Fotomaterjal/dolly/Asjad/20141008_165119.jpg

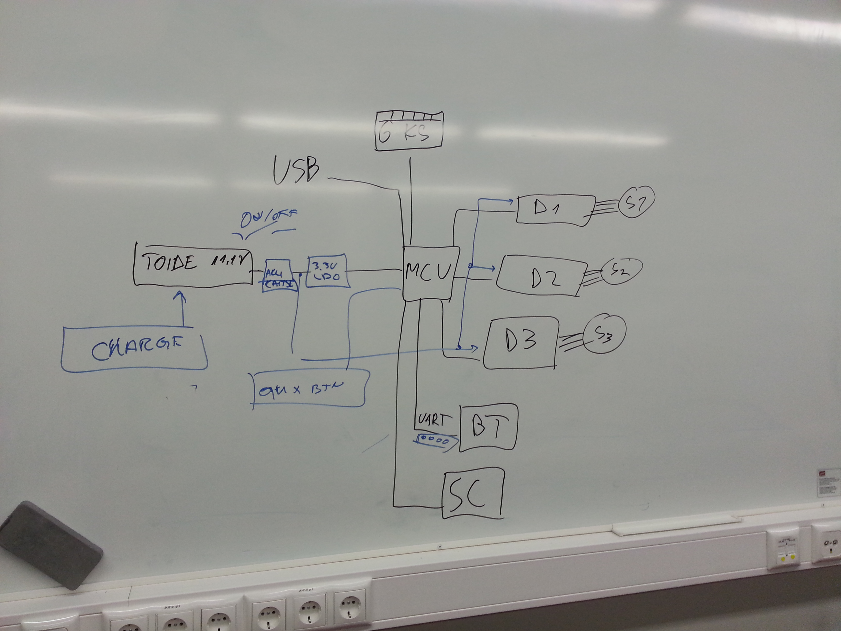
Asjad/20141008_165119.jpg
