Fotomaterjal/dolly/Asjad/work in progress_solid.PNG

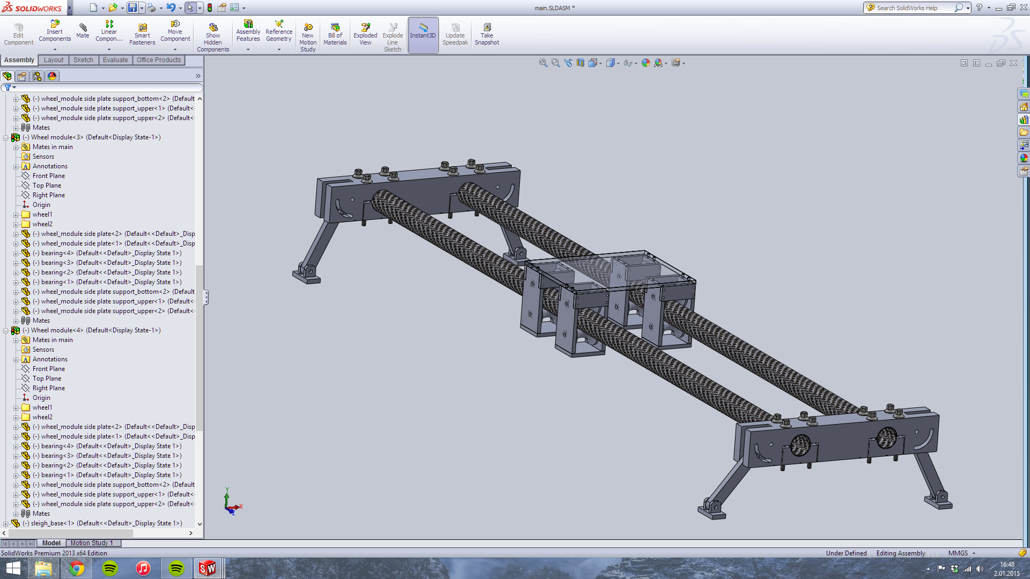
Asjad/work in progress_solid.PNG
