Fotomaterjal/dolly/Asjad/Plokkskeem.docx

UART

Start/stop

ON/OFF switch

3.3V

Battery protect

Charge

Power
11.1 V

BLUETOOTH

USB

Shutter control

6 killswitches

S1

S3

Driver 3

Driver 1

MCU

S2

Driver 2
