Fotomaterjal/dolly/Solidworks/Eelarve_B26135_lõputöö.pdf

Komponent | Kogus | Hind kokku € (koos tellimisega)

# Link

Süsinikkiust relss 1200 mm | 2 | 75 http://www.ebay.com/itm/1pcs-30X28X1200MM-Carbon-fiber-tube-for-Quadcopter-Hexrcopter-arm-3K-Twill-matt-/221540058010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
Steppermootor | 3 | 144 http://www.ebay.com/itm/17Kg-cm-42-Stepper-Motor-with-5mm-Shaft-5-18-1-Planetary-Gearbox-for-3D-Printer-/141391145774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
Laagrid ülekannete jaoks | 3 | 12
Laagrid kaamera aluse tarvis | 2 | 15
Laagrid rataste jaoks | 8 | 18
Liblikmutrid | 8 | 8
Vintraud | 1 | 8
Poldid | 48 | 14
Mutrid | 40 | 10
Ülekanderihm | 1 | 10 http://www.ebay.com/itm/RepRap-2x-GT2-20T-5mm-Bore-Pulleys-2M-Timing-Belt-Set-for-3D-printer-Prusa-FE-/121428898130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
3D-printeri plastik | 1 | 20
Peegelkaamera statiivpea | 1 | 39 http://www.ebay.com/itm/15KG-Aluminum-Ball-Head-Ballhead-Quick-Release-Plate-for-Tripod-DSLR-Camera-/181397654016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
Raud/alumiinium | 1 | 45
Separaatorid | 18 | 15
Aku | 1 | 32 http://www.ebay.com/itm/YKS-11-1V-5000mah-25C-MAX-40C-3S-Lipo-Battery-For-RC-Helicopter-Plane-/171404551408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
Lipoplaat | 1 | 6 http://www.ebay.com/itm/A-PCM-Protection-Circuit-Module-For-11-1V-3S-Li-ion-Li-Po-Battery-pack-6A-SM936-/220967028845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
Lipo kott | 1 | 3,7 http://www.ebay.com/itm/NEW-LiPo-RC-Battery-Safe-Guard-bag-Charging-Sack-save-pack-E-/261480890022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
Kaablid mootorite/päästiku jaoks | 3 | 9
Lipo laadija | 1 | 52 http://www.ebay.com/itm/iMAX-B6AC-RC-R-C-Plane-Car-LiPo-LiIon-LiFe-NiCd-NiMh-Battery-Balance-Charger-/171327219127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
Kokku: | 535,7
