Fotomaterjal/dolly/Eagle/Electronics links.xlsx

Jupp | Kogus | Hind kokku | Saadavus | Link | äkki on see parem
Allegromicro A4984 stepperi draiver | 3 |  |  | http://ee.farnell.com/allegro-microsystems/a4982slptr-t/motor-driver-microstepping-24tssop/dp/2057415
Bluetooth HC-06 | 1 | 3.60 |  | http://www.ebay.com/itm/Wireless-Serial-4-Pin-Bluetooth-RF-Transceiver-Module-HC-06-RS232-With-backplane-/200924726178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
ATMEGA32U4 mikrokontroller | 1 | 5.89 |  | http://ee.farnell.com/atmel/atmega32u4-au/mcu-8bit-megaavr-16mhz-tqfp-44/dp/1748525?ref=lookahead
16 MHz kristall | 1 | 0.63 |  | http://ee.farnell.com/txc/9c-16-000meej-t/xtal-16-000mhz-18pf-smd-hc-49s/dp/1842294
Phototransistor | 1 | 0.603 |  | http://ee.farnell.com/fairchild-semiconductor/fod814a3sd/opto-cplr-phototrans-5kv-smd/dp/2322512
Screw terminal for motors | 3 | 3.06 |  | http://ee.farnell.com/multicomp/mc000036/terminal-block-pcb-5-08mm-4way/dp/2008006
100nF kondekad | 10 | 3.6 |  | http://ee.farnell.com/avx/06033c104jat2a/cap-mlcc-x7r-100nf-25v-0603/dp/1740614
1uF kondekad | 10 | 3.6 |  | http://ee.farnell.com/avx/06033d105kat2a/cap-mlcc-x5r-1uf-25v-0603/dp/1658868
10uF kondekad | 10 | 2.34 |  | http://ee.farnell.com/avx/12063c106kat2a/cap-mlcc-x7r-10uf-25v-1206/dp/2094044
100uF tantaal | 3 | 10.1 |  | http://ee.farnell.com/vishay-sprague/595d107x0025r2t/cap-tant-100uf-25v-case-r/dp/1469337
voltage regulator | 1 | 2.42 |  | http://ee.farnell.com/analog-devices/adp2302ardz-3-3/ic-buck-reg-2a-3-3v-8soic/dp/1843644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
shottky diood | 1 | 0.34 |  | http://ee.farnell.com/multicomp/b330b-13-f/diode-schottky-3a-30v-do-214aa/dp/2306114
inductor | 1 | 1.15 |  | http://ee.farnell.com/tdk/vlf10040t-6r8n4r5/inductor-power-line-6-8uh-4-5a/dp/1855390
USB connector | 1 |  |  | http://ee.farnell.com/samtec/musb-05-s-b-sm-a/connector-mini-usb-b-receptacle/dp/1753806
