Fotomaterjal/dolly/Asjad/Capture1.PNG

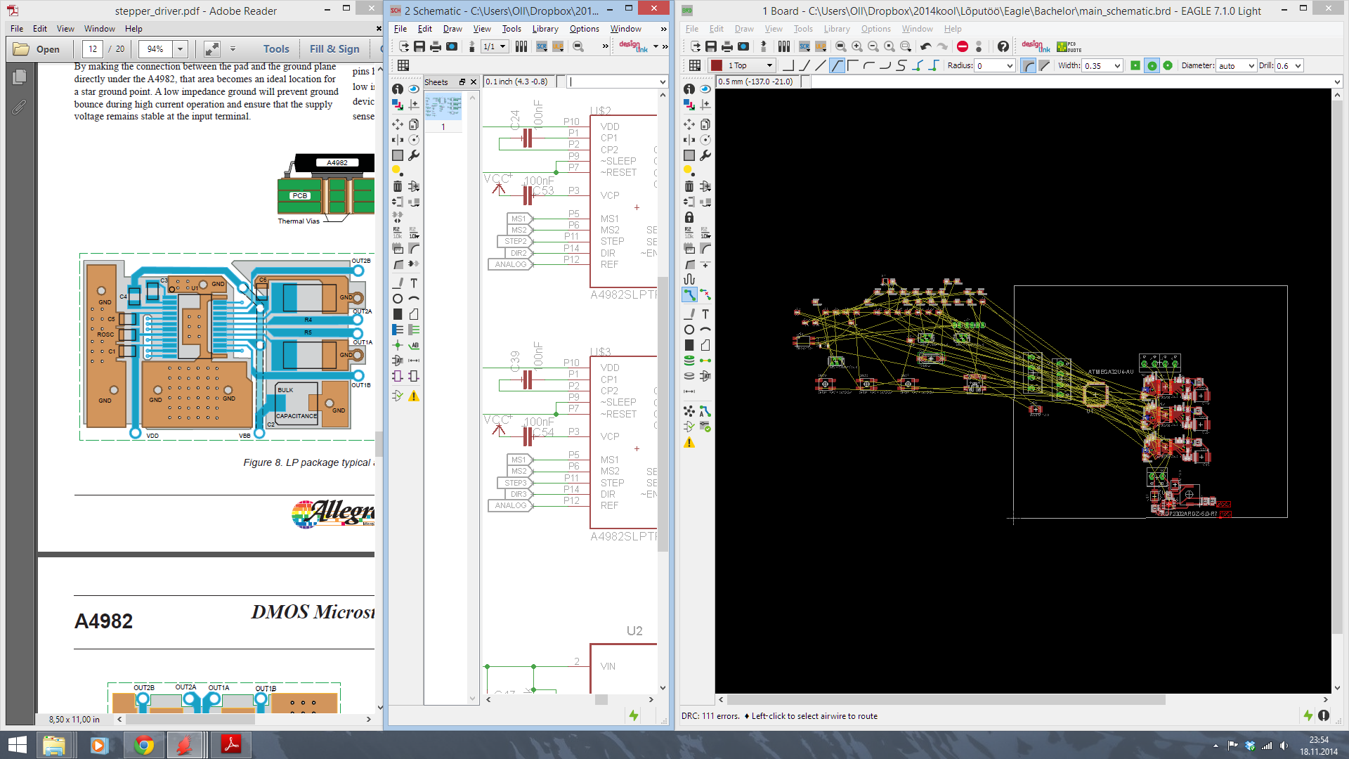
Asjad/Capture1.PNG
