Fotomaterjal/dolly/Asjad/Capture.PNG

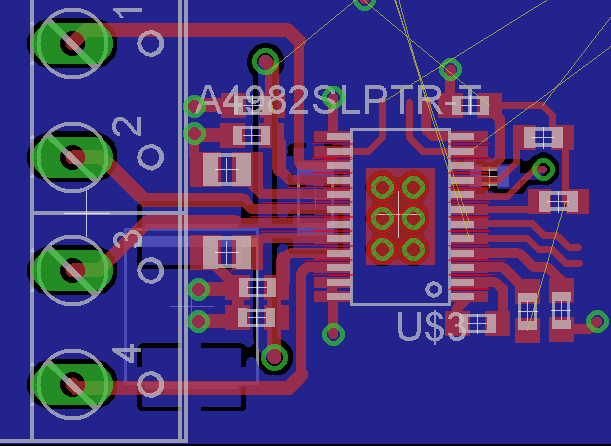
Asjad/Capture.PNG
