Fotomaterjal/dolly/Asjad/kogu plaat.PNG

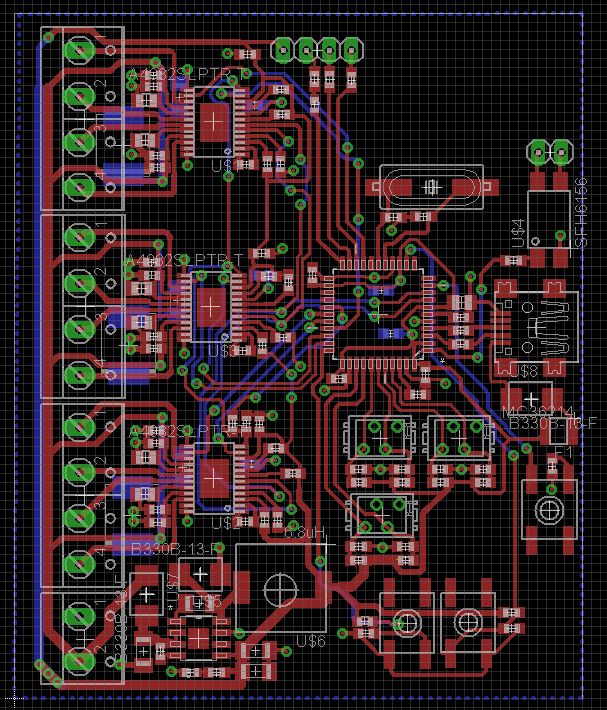
Asjad/kogu plaat.PNG
