Fotomaterjal/dolly/Asjad/plaat valma.PNG

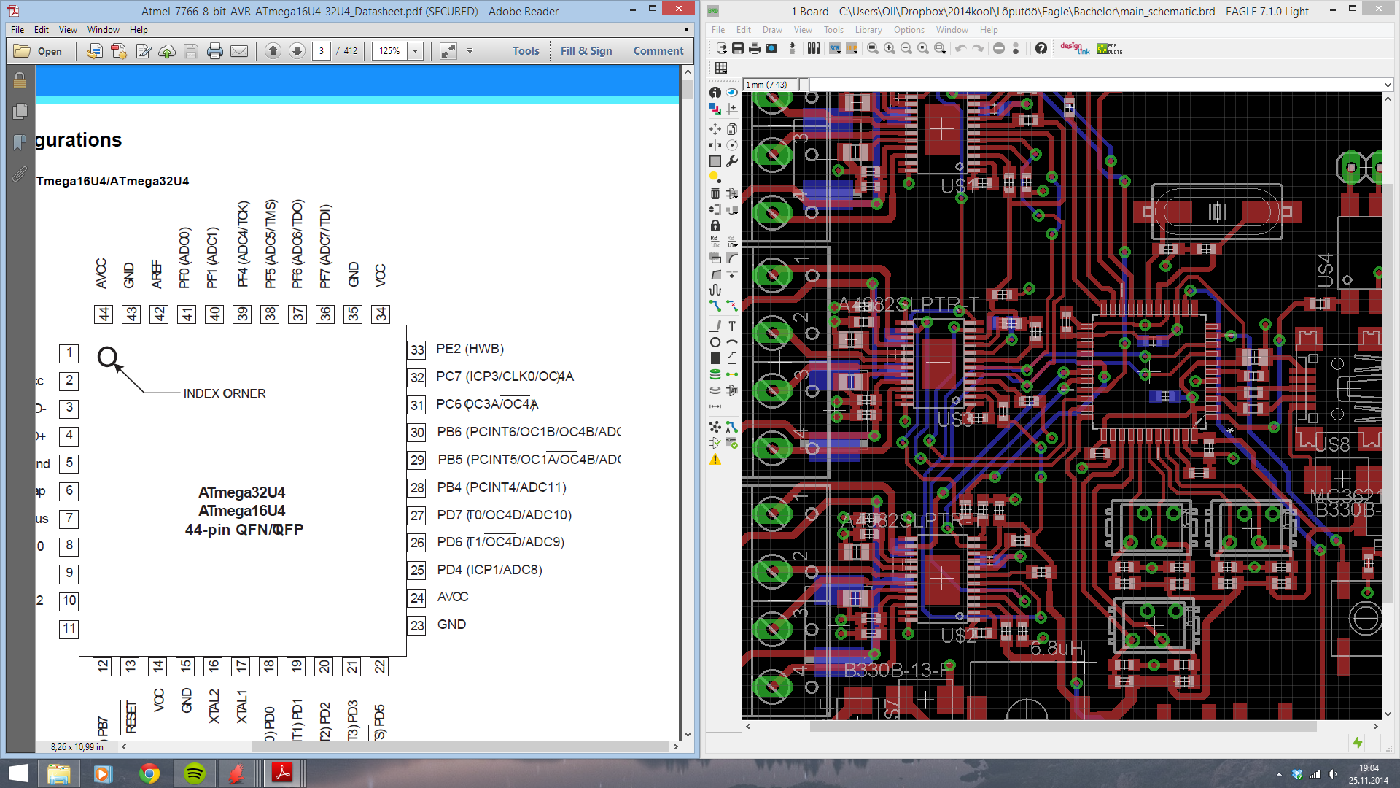
Asjad/plaat valma.PNG
