Fotomaterjal/dolly/Asjad/plokkskeem.PNG

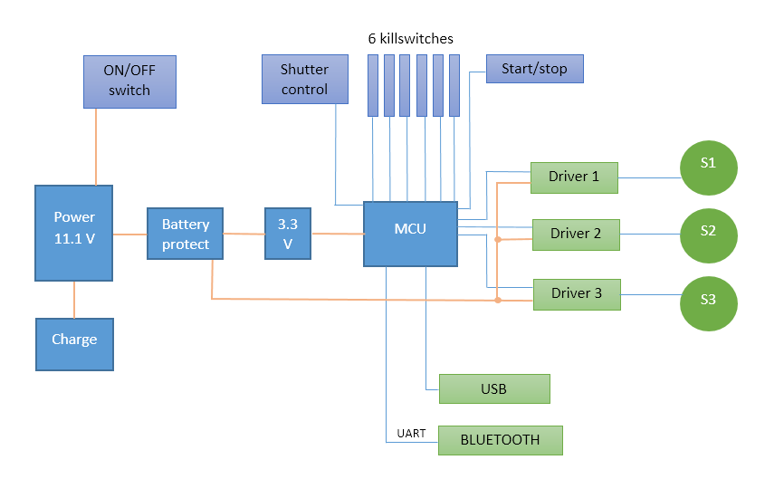
Asjad/plokkskeem.PNG
