Fotomaterjal/dolly/Asjad/work in progress.PNG

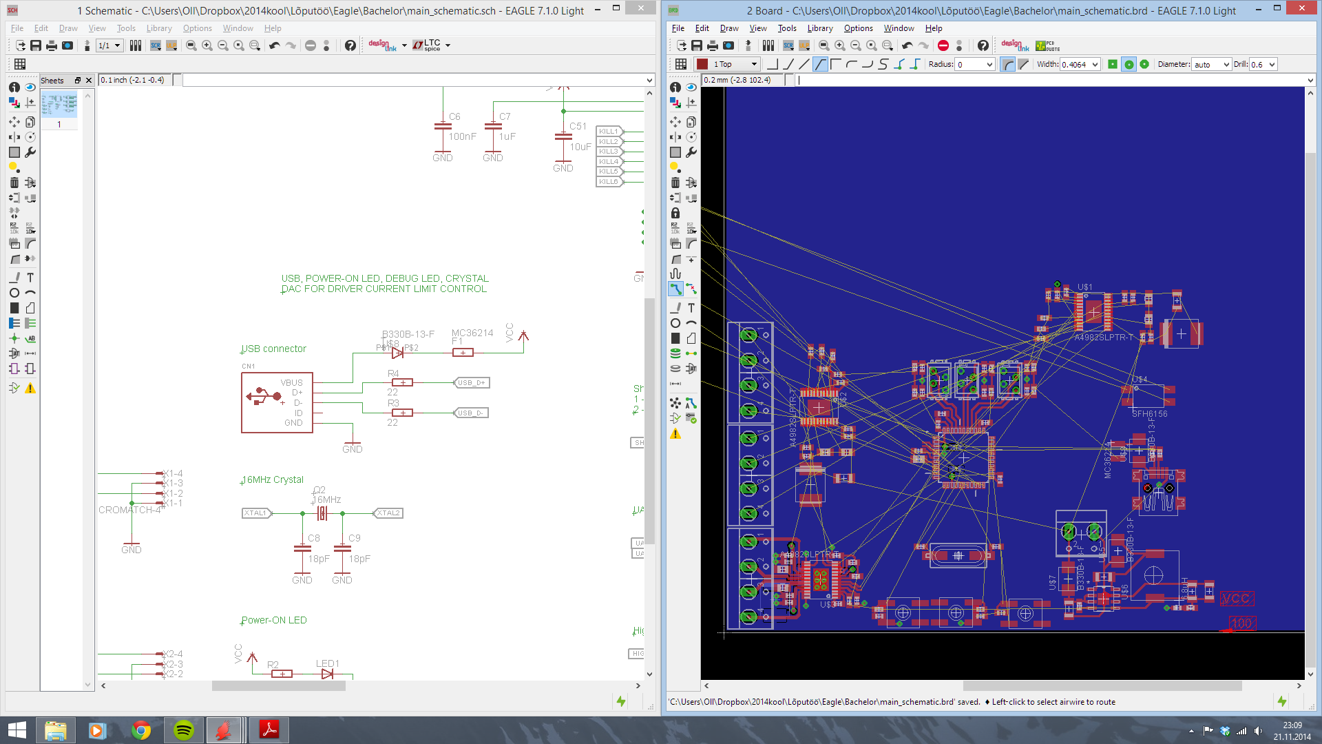
Asjad/work in progress.PNG
