Fotomaterjal/dolly/Asjad/ühenda draiver nii.PNG

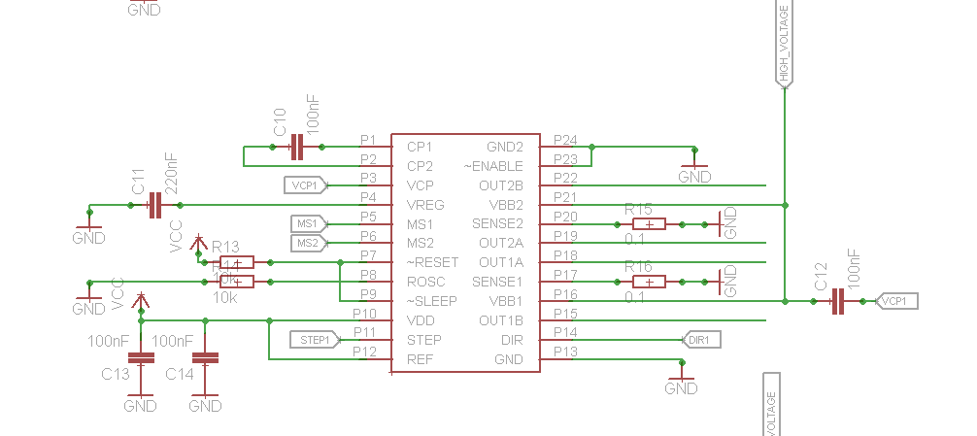
Asjad/ühenda draiver nii.PNG
