Fotomaterjal/dolly/Eagle/mida ühendada.PNG

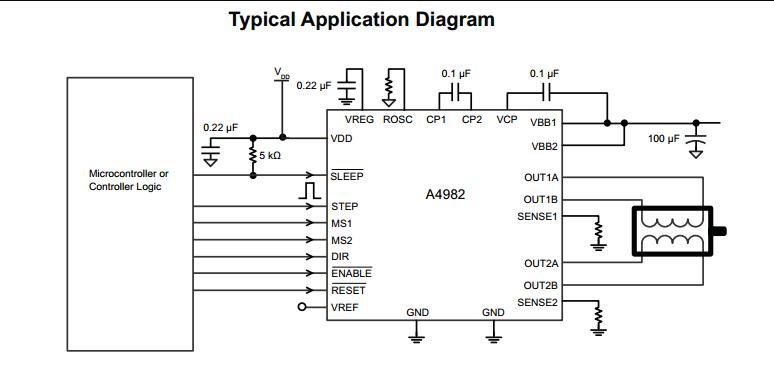
Eagle/mida ühendada.PNG
