Fotomaterjal/dolly/Progemine/cheatsheet.PNG

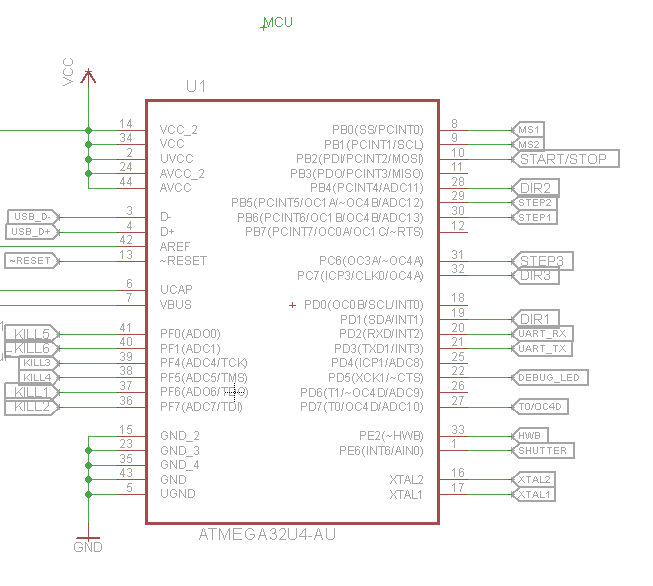
Progemine/cheatsheet.PNG
