Fotomaterjal/dolly/Eagle/BOM revisited2.txt

22uF, 2th, 1206			ok
LED 0603
Dioodid, 5tk			ok
0.1 oomi 0805, 10tk		ok
3,9k 0603			ok
100uF tantaalid 1469337 4tk	ok

1469337, 4, Salumaa CAP TANT 100UF 25V CASE R
1680071, 4, Salumaa RSX501L-20TE25  DIODE, SCHOTTKY
2320923, 10, Salumaa CAP MLCC X5R 22UF 16V 1206
2332010, 10, Salumaa RESISTOR POWER 3K9 0.2W 1% 0603
2381093, 10, Salumaa RESISTOR THICK FILM 0.1OHM 1% 0805
148507, 4, Salumaa PLUG IDC 1.27MM 4WAY on board
149032, 4, Salumaa PLUG, IDC, 1.27MM, 4WAY wire
