Fotomaterjal/dolly/Eagle/BOM.txt

Partlist exported from C:/Users/Oll/Dropbox/2014kool/Lõputöö/Eagle/Bachelor/main_schematic.sch at 2.12.2014 10:23:13

Part Value              Device              Package                 Description                                             MF MPN                OC_FARNELL OC_NEWARK PACKAGE SUPPLIER      
C1   100nF              C-EUC0603K          C0603K                  CAPACITOR, European symbol                                                                                               
C2   100nF              C-EUC0603K          C0603K                  CAPACITOR, European symbol                                                                                               
C3   100nF              C-EUC0603K          C0603K                  CAPACITOR, European symbol                                                                                               
C4   100nF              C-EUC0603K          C0603K                  CAPACITOR, European symbol                                                                                               
C5   100nF              C-EUC0603K          C0603K                  CAPACITOR, European symbol                                                                                               
C6   100nF              C-EUC0603K          C0603K                  CAPACITOR, European symbol                                                                                               
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
U$8  B330B-13-F         SCHOTTK_YB330B-13-F B330B-13-F                                                                                                                                       
U1   ATMEGA32U4-AU      ATMEGA32U4-AU       QFP80P1200X1200X120-44N 8-bit Microcontroller with ISP Flash and USB Controller    ATMEGA32U4-AU      1748525    26R5633   TQFP-44 Atmel         
U2   ADP2302ARDZ-5.0-R7 ADP2302ARDZ-5.0-R7  SOIC127P600X175-9N      Step-Down Regulators                                       ADP2302ARDZ-5.0-R7 2312892    67W2704   SOIC-8  Analog Devices
X1   MICROMATCH-4       MICROMATCH-4        MICROMATCH-4            MicroMaTch 4  7-215464-4 / 0-215464-4                      7-215464-4         3784629    19R8124                         
X2   MICROMATCH-4       MICROMATCH-4        MICROMATCH-4            MicroMaTch 4  7-215464-4 / 0-215464-4                      7-215464-4         3784629    19R8124                         
X3   MICROMATCH-4       MICROMATCH-4        MICROMATCH-4            MicroMaTch 4  7-215464-4 / 0-215464-4                      7-215464-4         3784629    19R8124                         
X4                      W237-02P            W237-132                WAGO SREW CLAMP                                                               unknown    unknown                         
X5                      W237-04P            W237-4P                 WAGO SREW CLAMP                                                               unknown    unknown                         
X7                      W237-04P            W237-4P                 WAGO SREW CLAMP                                                               unknown    unknown                         
X8                      W237-04P            W237-4P                 WAGO SREW CLAMP                                                               unknown    unknown
