Fotomaterjal/dolly/Solidworks/Battery/Battery.SLDASM

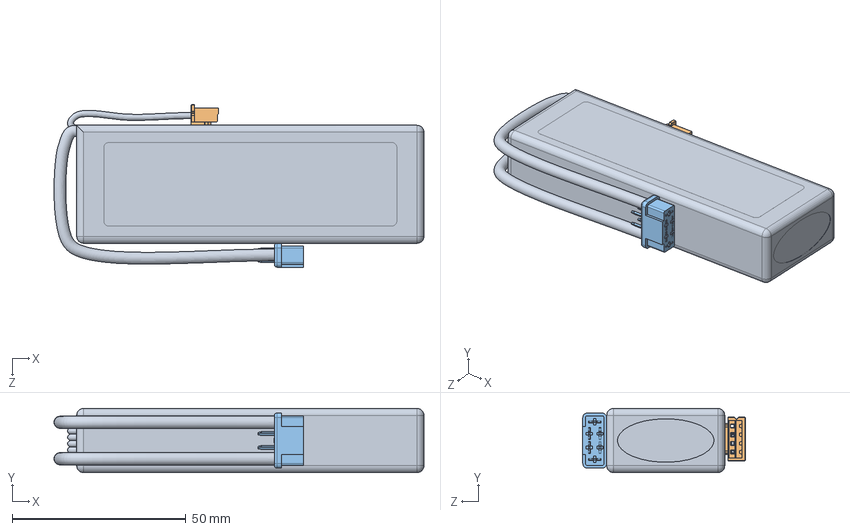
[picture p12: CAD file, 2015-05-10]
Solidworks/Battery/Battery.SLDASM
106.5 x 18.5 x 46.8 mm
Nanotech_1600mAh_3S_Lipo
Connector JST XHP-4
CONNECTOR, MULTIPLEX, PLUG
