Fotomaterjal/dolly/Solidworks/PCB/PCB assembly.SLDASM

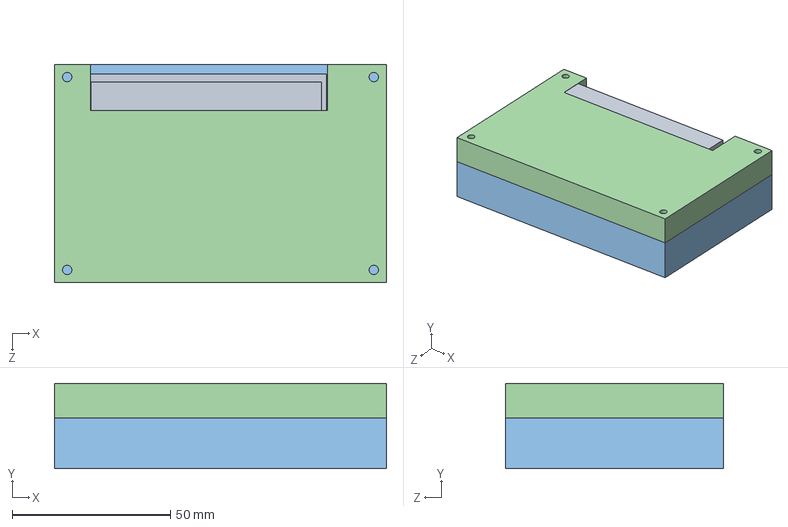
[picture p13: CAD file, 2015-06-13]
Solidworks/PCB/PCB assembly.SLDASM
105.0 x 27.0 x 69.0 mm
main_pcb
BTModule
pcbBox_bottom
pcbBox_top
