Fotomaterjal/dolly/Solidworks/Sleigh/Horizontal Rotation/HorRotate_assembly.SLDASM

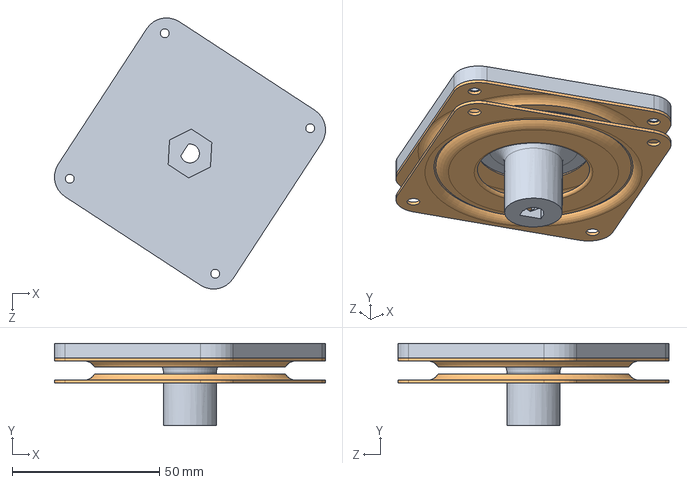
[picture p14: CAD file, 2015-06-13]
Solidworks/Sleigh/Horizontal Rotation/HorRotate_assembly.SLDASM
92.1 x 28.0 x 92.1 mm
HorRotateAdapter
LazySusan_part x 2
