Fotomaterjal/dolly/Solidworks/Sleigh/Roller Module/Roller_module.SLDASM

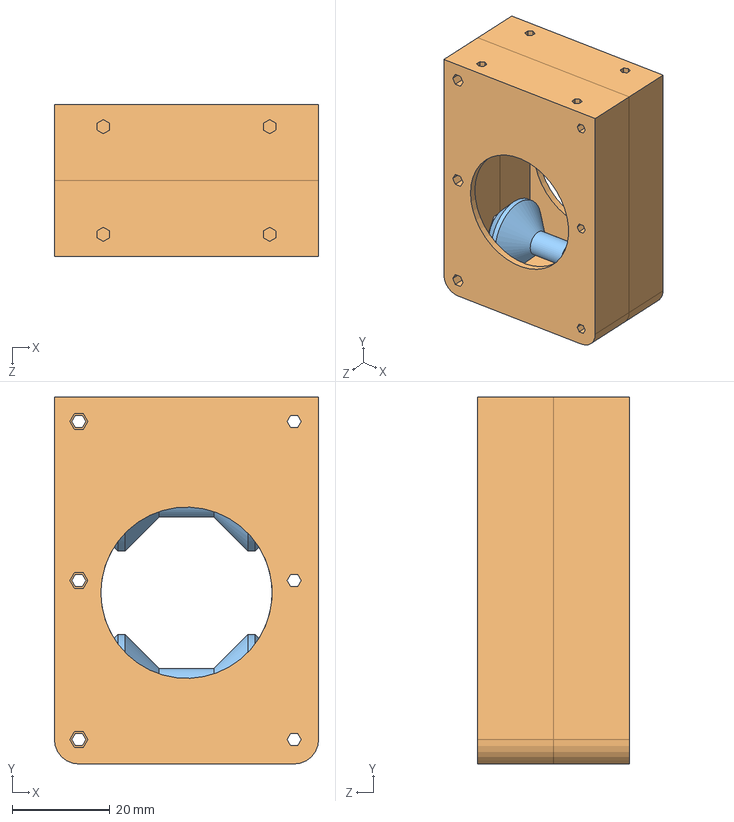
[picture p15: CAD file, 2015-06-13]
Solidworks/Sleigh/Roller Module/Roller_module.SLDASM
54.0 x 75.0 x 31.0 mm
WheelHandler_bearing x 4
WheelHandler_half_block x 2
WheelHandler_wheel x 2
