Fotomaterjal/dolly/Solidworks/Stepper/2_NEMA 17.SLDASM

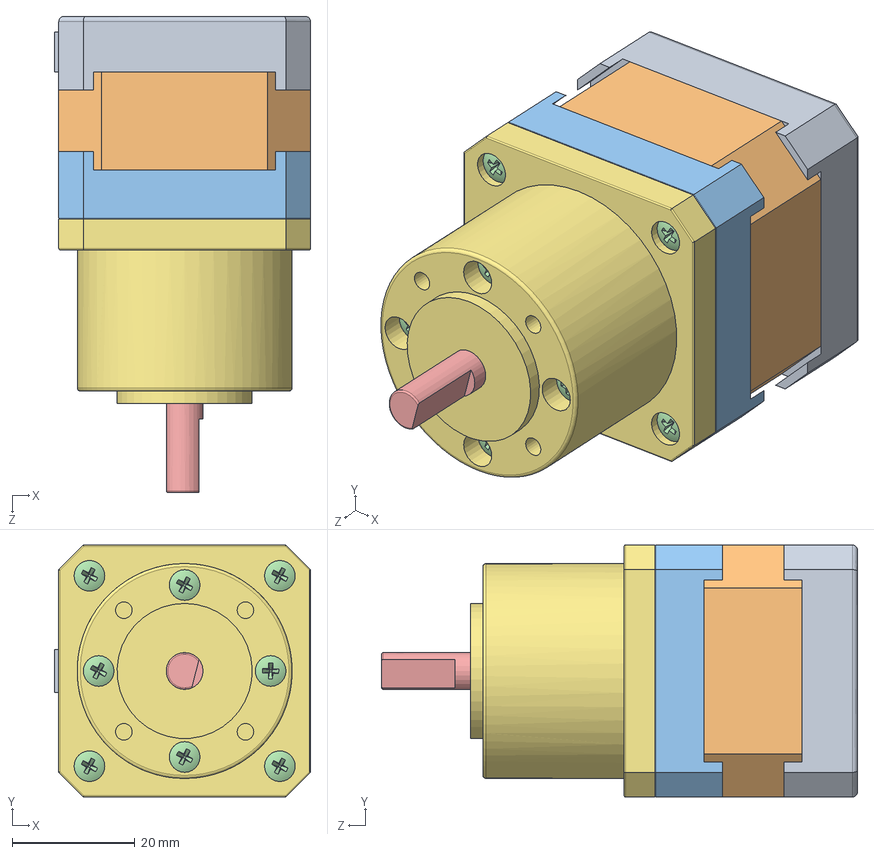
[picture p16: CAD file, 2015-06-13]
Solidworks/Stepper/2_NEMA 17.SLDASM
41.7 x 41.0 x 77.5 mm
Base
Cuerpo
Tapa
pan cross head_am x 12
Eje
instrument ball bearing_68_am
Gearbox
