Fotomaterjal/dolly/Solidworks/PCB/main_pcb.SLDPRT

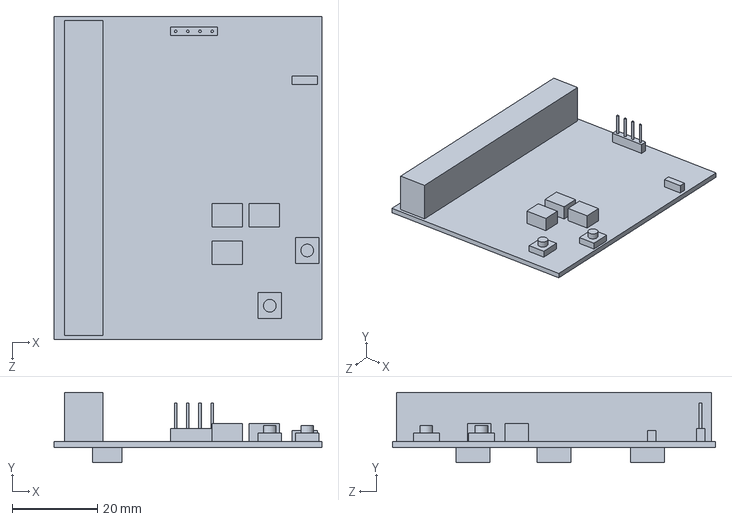
[picture p17: CAD file, 2015-06-13]
Solidworks/PCB/main_pcb.SLDPRT
63.0 x 16.5 x 76.0 mm
