Fotomaterjal/dolly/Solidworks/Sleigh/Linear movement/Belt tightener transmission.SLDASM

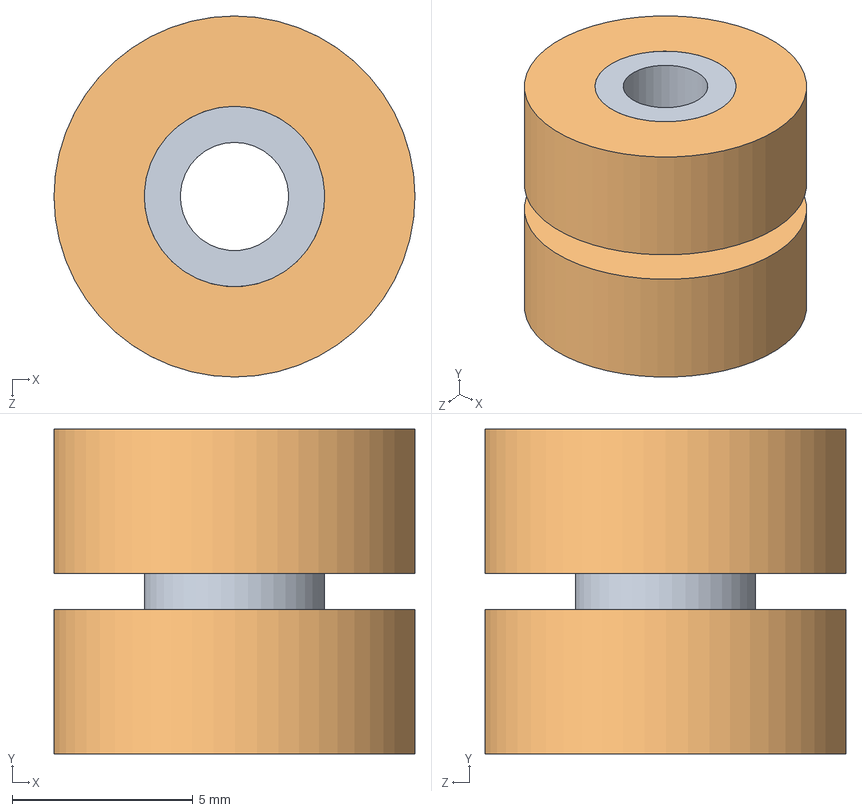
[picture p18: CAD file, 2015-06-13]
Solidworks/Sleigh/Linear movement/Belt tightener transmission.SLDASM
10.0 x 9.00 x 10.0 mm
Screw_bearing adapter
WheelHandler_bearing x 2
