Fotomaterjal/dolly/Solidworks/Sleigh/Vertical Rotation/VerRotate_assembly base_long.SLDPRT

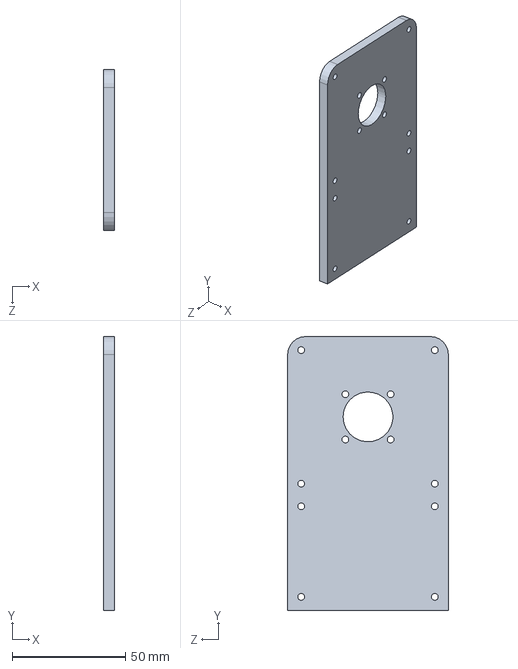
[picture p19: CAD file, 2015-05-10]
Solidworks/Sleigh/Vertical Rotation/VerRotate_assembly base_long.SLDPRT
5.00 x 121.0 x 71.0 mm
