Fotomaterjal/dolly/Solidworks/Bottom/Sideblock_module.SLDASM

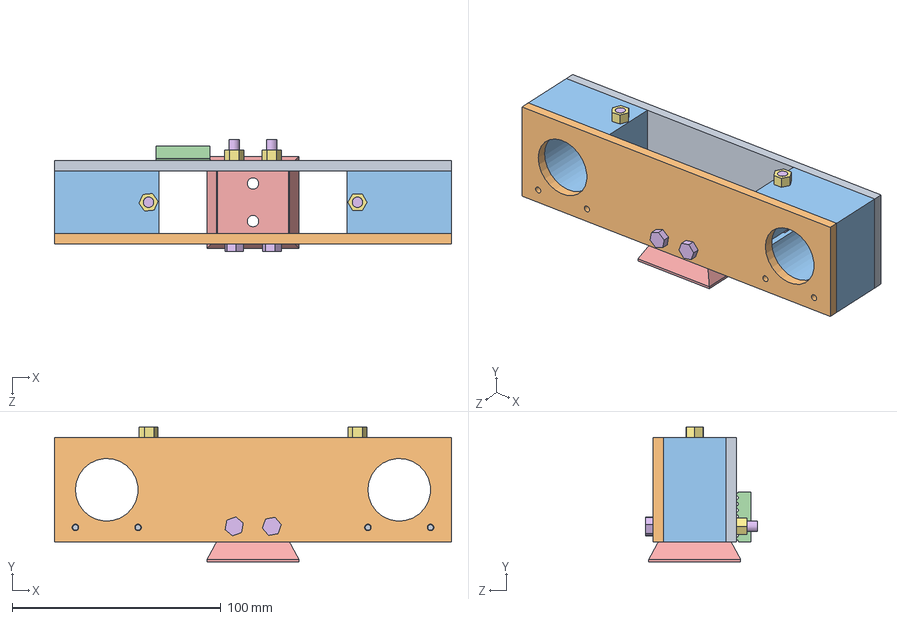
[picture p20: CAD file, 2015-06-13]
Solidworks/Bottom/Sideblock_module.SLDASM
190.0 x 64.5 x 53.5 mm
Sideblock_sideplate_w_beltfastener
Sideblock_sideplate_wo_beltfastener
Sideblock_tubeFastener x 2
Sideblock_belt_fastener
Tripod_plate_2
Tripod_plate_bolt x 4
Tripod_plate_nut x 4
