Fotomaterjal/dolly/Solidworks/Sleigh/Vertical Rotation/VerRotate_assembly base.SLDPRT

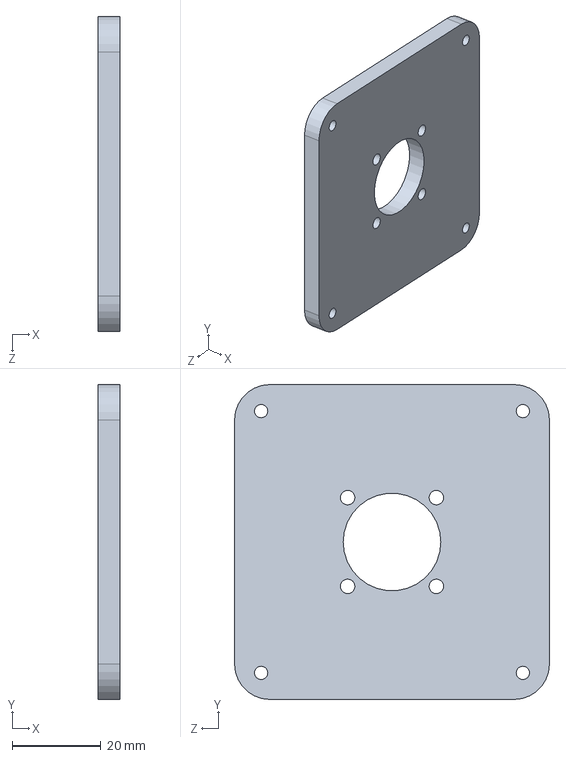
[picture p21: CAD file, 2015-04-08]
Solidworks/Sleigh/Vertical Rotation/VerRotate_assembly base.SLDPRT
5.00 x 71.0 x 71.0 mm
