Fotomaterjal/dolly/Solidworks/Bottom/Sideblock_tubeFastener.SLDPRT

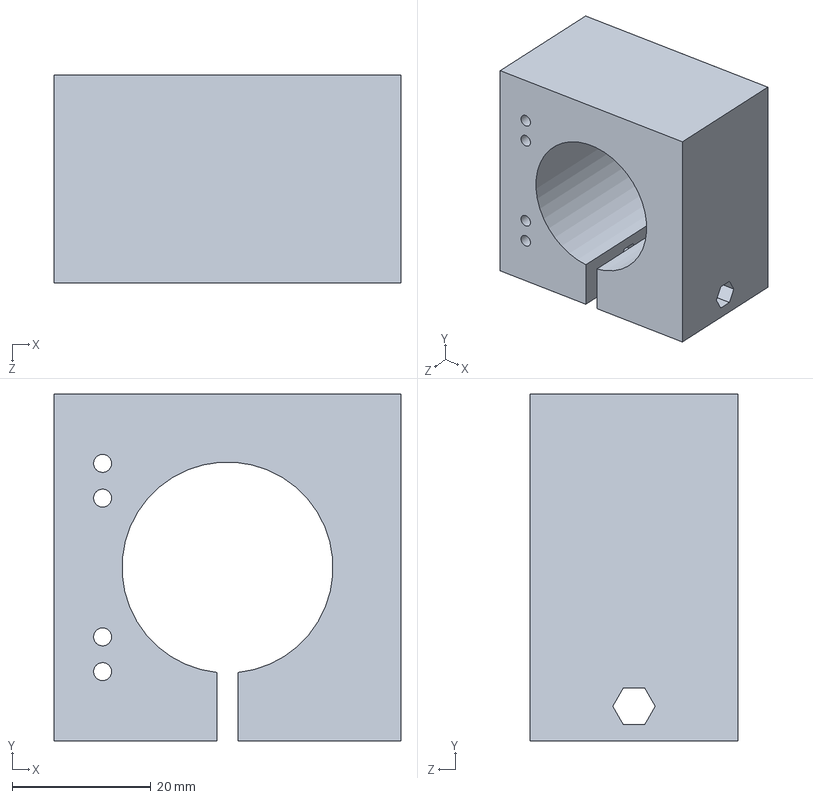
[picture p22: CAD file, 2015-06-13]
Solidworks/Bottom/Sideblock_tubeFastener.SLDPRT
50.0 x 50.0 x 30.0 mm
