Fotomaterjal/dolly/Solidworks/carbon_tube_1m.SLDPRT

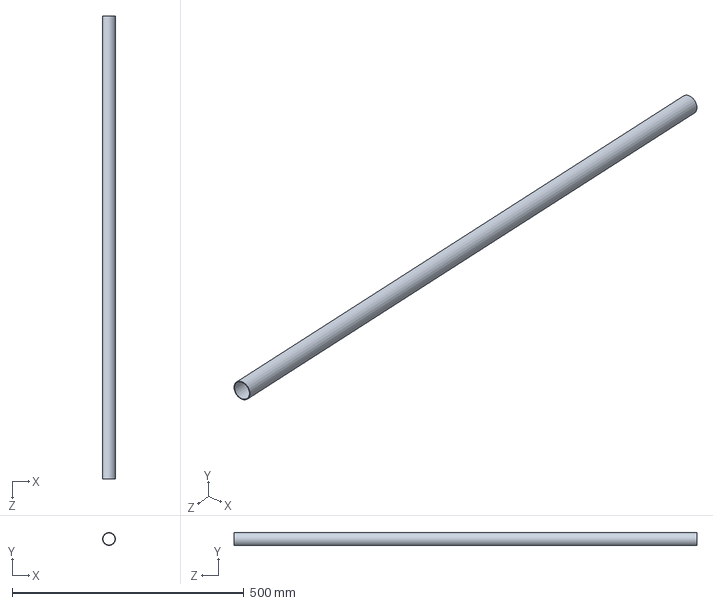
[picture p23: CAD file, 2015-01-03]
Solidworks/carbon_tube_1m.SLDPRT
28.0 x 28.0 x 1000.0 mm
