Fotomaterjal/dolly/Solidworks/Misc parts/8020-3048.SLDPRT

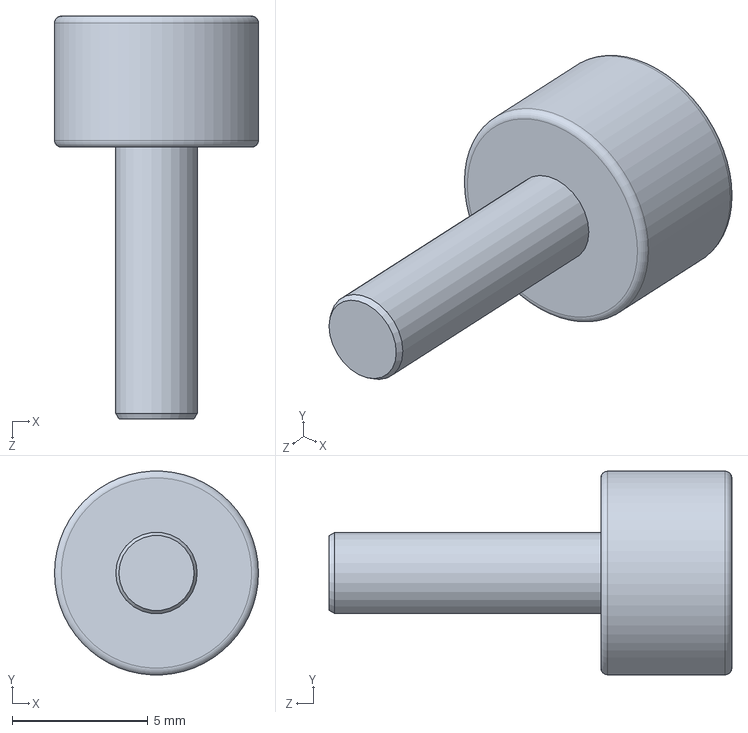
[picture p24: CAD file, 2015-04-08]
Solidworks/Misc parts/8020-3048.SLDPRT
7.51 x 7.50 x 14.8 mm
