Fotomaterjal/dolly/Solidworks/Sleigh/Sleigh_top_plate.SLDPRT

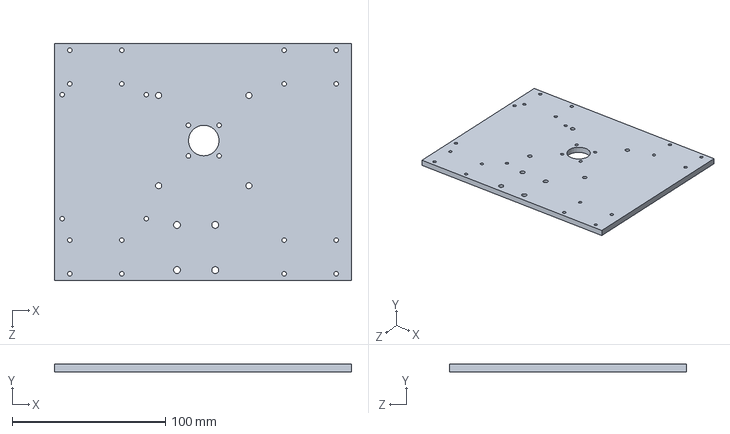
[picture p25: CAD file, 2015-05-10]
Solidworks/Sleigh/Sleigh_top_plate.SLDPRT
194.0 x 5.00 x 155.0 mm
