Fotomaterjal/dolly/Solidworks/Sleigh/Vertical Rotation/Aluminum_krauta/verRotate_90degree_bracket_other_side.SLDPRT

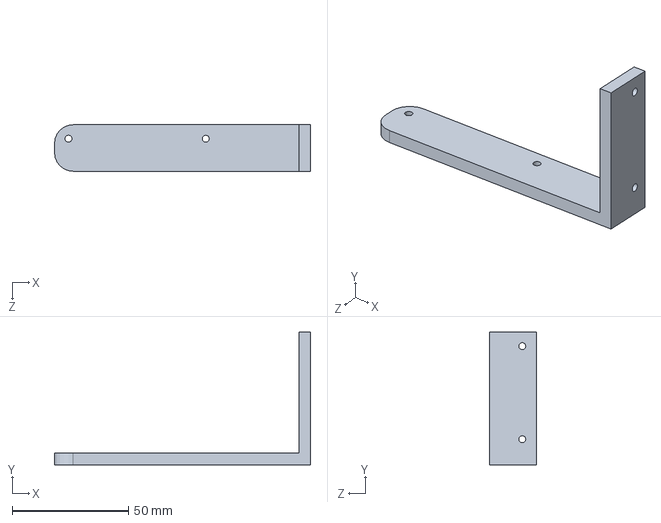
[picture p26: CAD file, 2015-05-10]
Solidworks/Sleigh/Vertical Rotation/Aluminum_krauta/verRotate_90degree_bracket_other_side.SLDPRT
110.0 x 57.0 x 20.0 mm
