Fotomaterjal/dolly/Solidworks/Sleigh/Vertical Rotation/VerRotate_adapter.SLDPRT

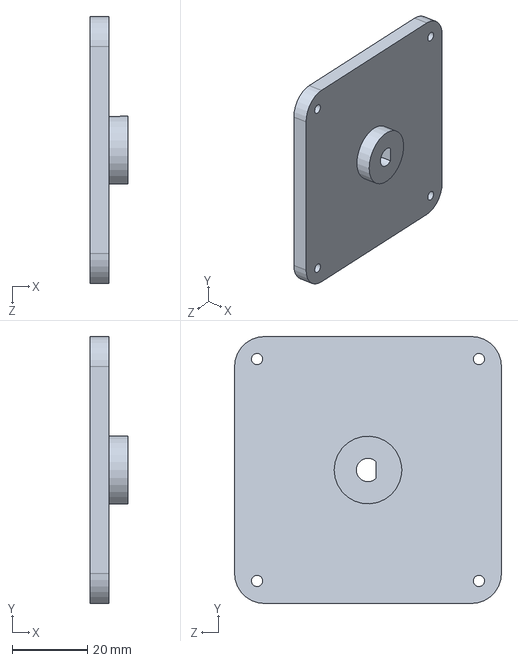
[picture p27: CAD file, 2015-06-13]
Solidworks/Sleigh/Vertical Rotation/VerRotate_adapter.SLDPRT
10.0 x 71.0 x 71.0 mm
