Fotomaterjal/dolly/Solidworks/Battery/Connector JST XHP-4.SLDPRT

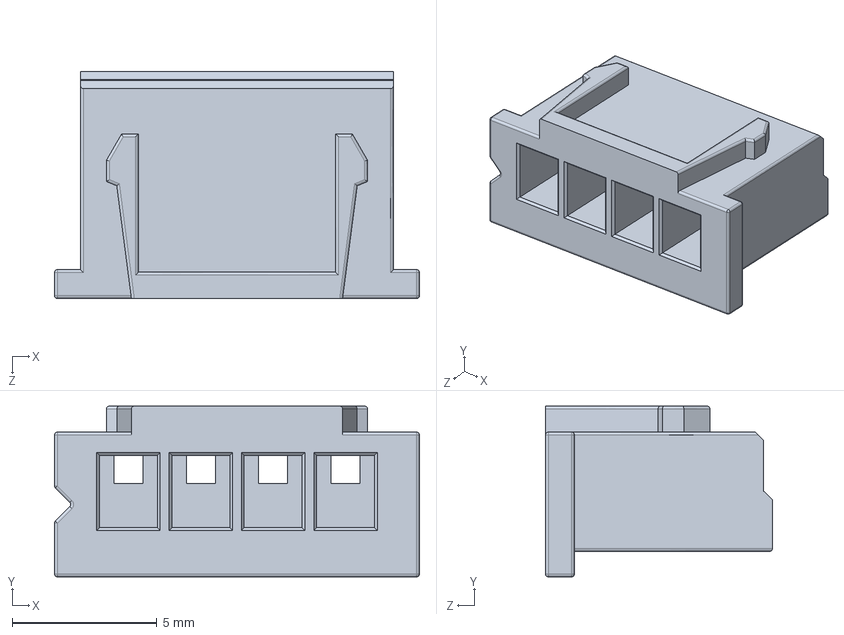
[picture p28: CAD file, 2015-04-08]
Solidworks/Battery/Connector JST XHP-4.SLDPRT
12.6 x 5.90 x 7.84 mm
