Fotomaterjal/dolly/Solidworks/Bottom/Tripod_plate.SLDPRT

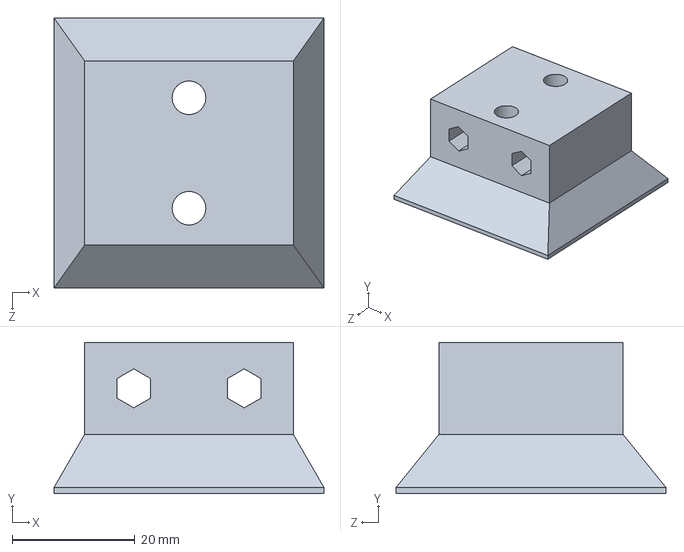
[picture p29: CAD file, 2015-06-13]
Solidworks/Bottom/Tripod_plate.SLDPRT
44.0 x 24.7 x 44.0 mm
