Fotomaterjal/dolly/Solidworks/Sleigh/Horizontal Rotation/HorRotateAdapter.SLDPRT

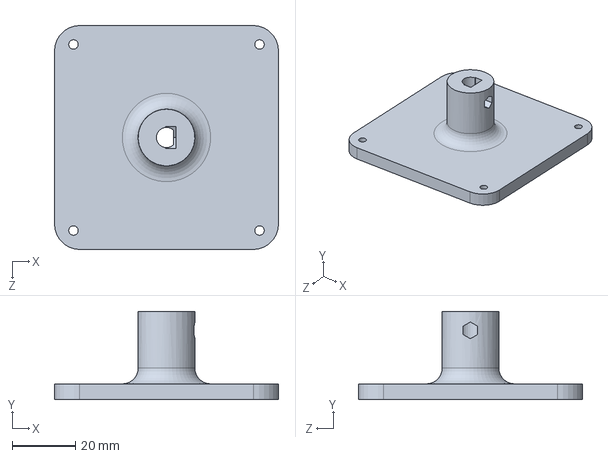
[picture p30: CAD file, 2015-06-13]
Solidworks/Sleigh/Horizontal Rotation/HorRotateAdapter.SLDPRT
71.0 x 28.0 x 71.0 mm
