Fotomaterjal/dolly/Solidworks/Sleigh/Roller Module/WheelHandler_half_block.SLDPRT

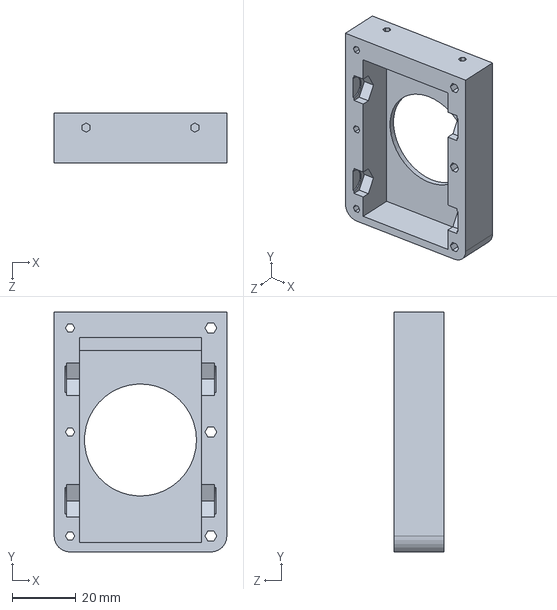
[picture p31: CAD file, 2015-05-10]
Solidworks/Sleigh/Roller Module/WheelHandler_half_block.SLDPRT
54.0 x 75.0 x 15.5 mm
