Fotomaterjal/dolly/Solidworks/Sleigh/Vertical Rotation/Aluminum_krauta/verRotate_90degree_camera_bracket_al.SLDPRT

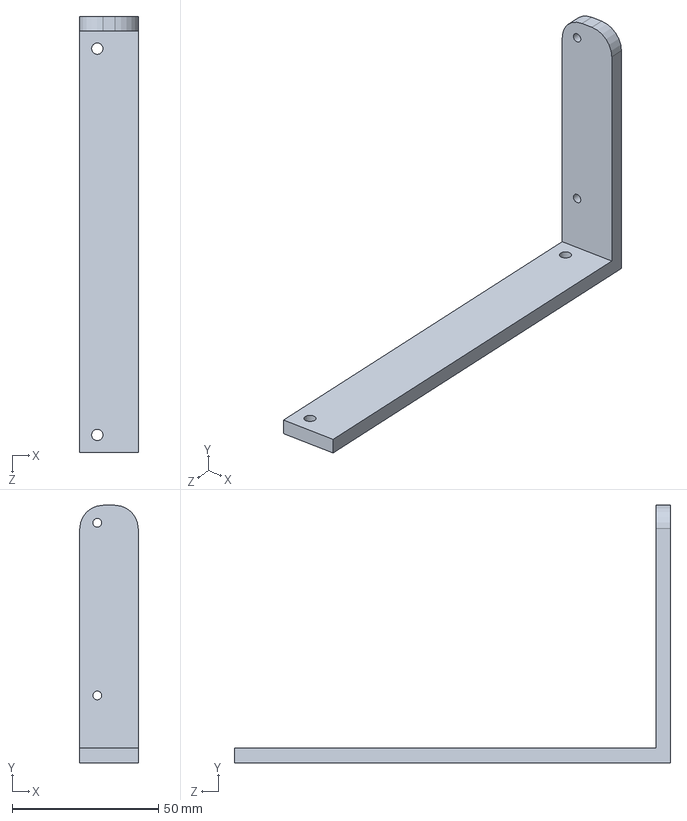
[picture p32: CAD file, 2015-05-10]
Solidworks/Sleigh/Vertical Rotation/Aluminum_krauta/verRotate_90degree_camera_bracket_al.SLDPRT
20.0 x 88.0 x 149.0 mm
