Fotomaterjal/dolly/Solidworks/Sleigh/Vertical Rotation/verRotate_camera_baseplate.SLDPRT

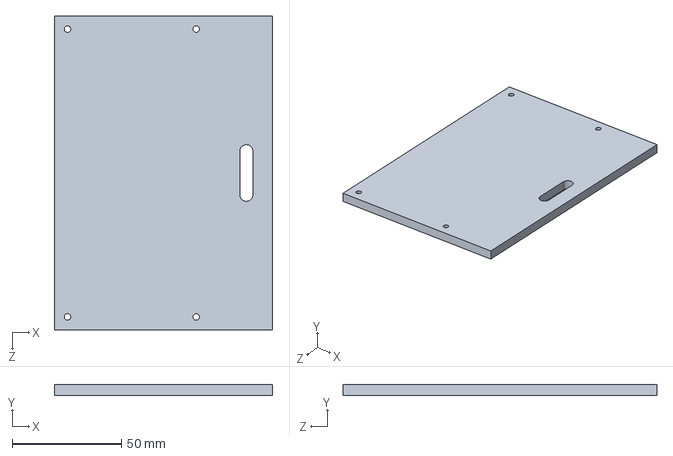
[picture p33: CAD file, 2015-05-10]
Solidworks/Sleigh/Vertical Rotation/verRotate_camera_baseplate.SLDPRT
100.0 x 5.00 x 144.0 mm
