Fotomaterjal/dolly/Solidworks/Stepper/Hex_M3x20.SLDPRT

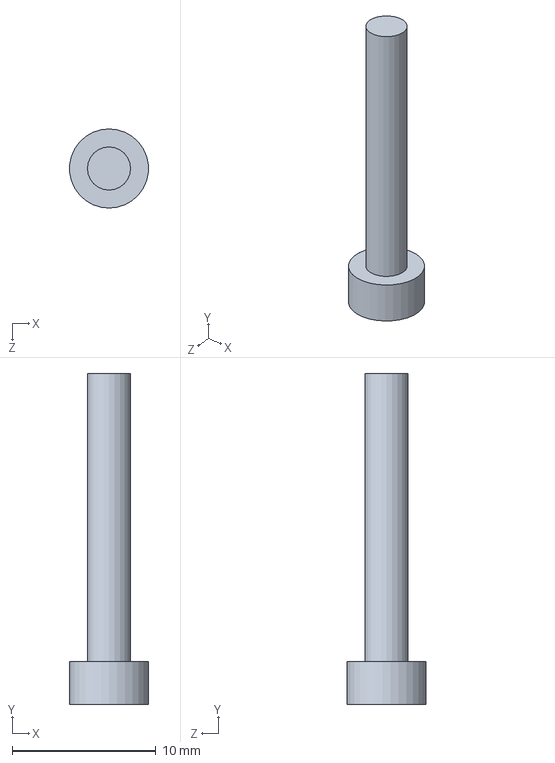
[picture p34: CAD file, 2015-04-08]
Solidworks/Stepper/Hex_M3x20.SLDPRT
5.47 x 23.0 x 5.50 mm
