Fotomaterjal/dolly/Solidworks/Battery/Nanotech_1600mAh_3S_Lipo.SLDPRT

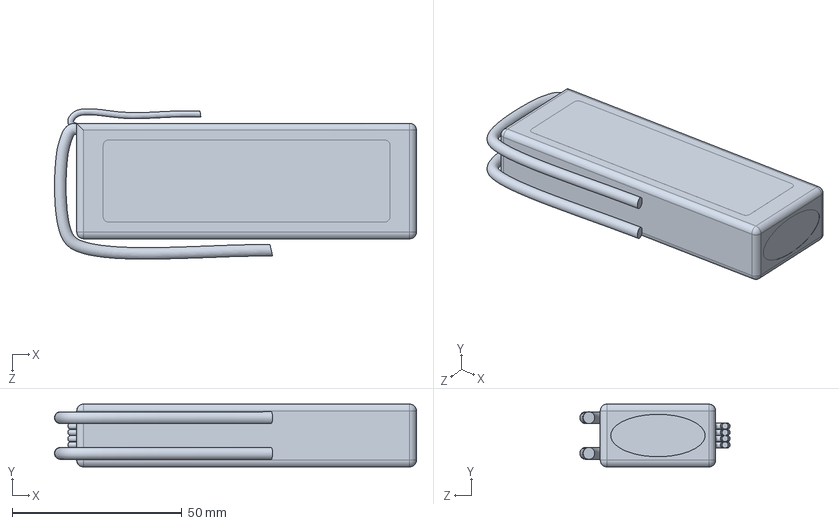
[picture p35: CAD file, 2015-04-08]
Solidworks/Battery/Nanotech_1600mAh_3S_Lipo.SLDPRT
106.5 x 18.5 x 44.3 mm
