Fotomaterjal/dolly/Solidworks/Bottom/Sideblock_belt_fastener.SLDPRT

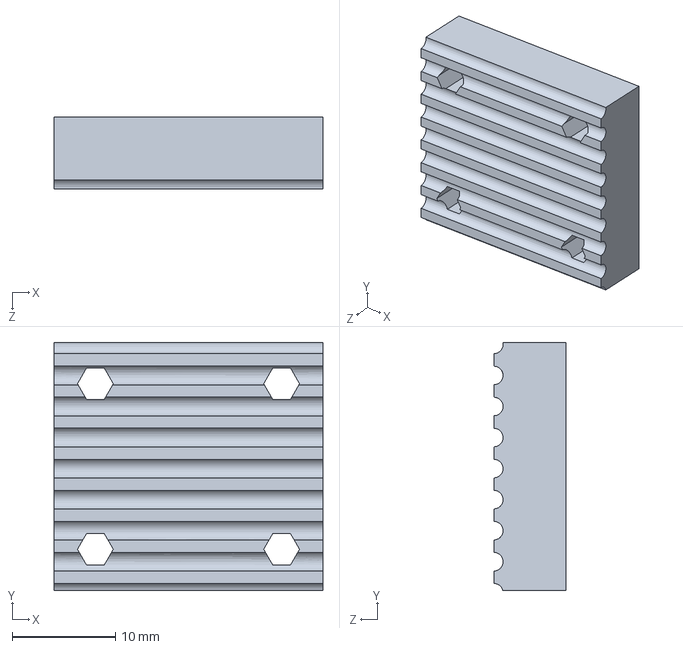
[picture p36: CAD file, 2015-06-13]
Solidworks/Bottom/Sideblock_belt_fastener.SLDPRT
26.0 x 24.0 x 7.00 mm
