Fotomaterjal/dolly/Solidworks/PCB/BTModule.SLDPRT

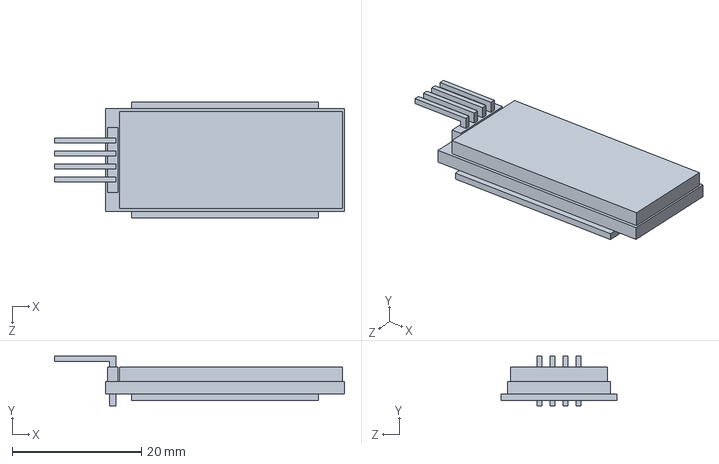
[picture p37: CAD file, 2015-04-08]
Solidworks/PCB/BTModule.SLDPRT
44.9 x 7.70 x 18.0 mm
