Fotomaterjal/dolly/Solidworks/Sleigh/Roller Module/WheelHandler_wheel.SLDPRT

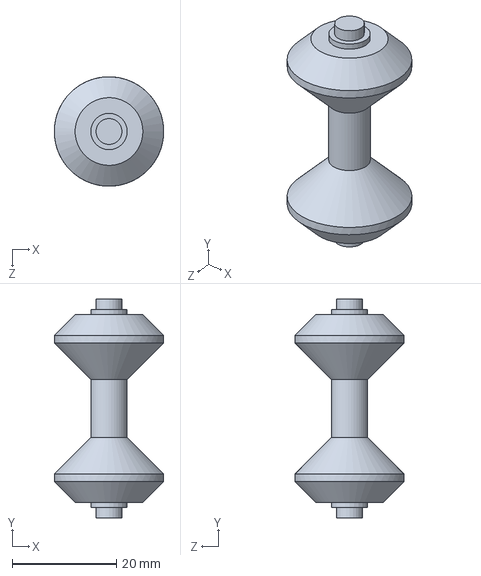
[picture p38: CAD file, 2015-04-08]
Solidworks/Sleigh/Roller Module/WheelHandler_wheel.SLDPRT
21.0 x 42.0 x 21.0 mm
