Fotomaterjal/dolly/Solidworks/Stepper/Stepper_aluminum_part.SLDPRT

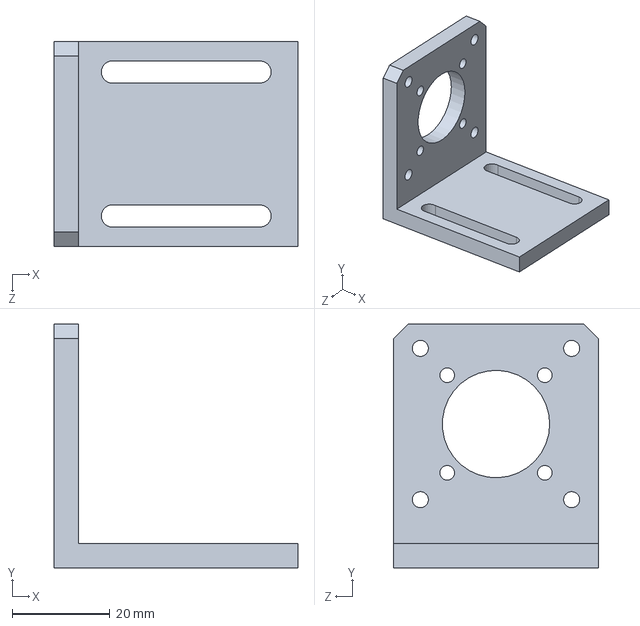
[picture p39: CAD file, 2015-04-08]
Solidworks/Stepper/Stepper_aluminum_part.SLDPRT
50.0 x 50.0 x 42.0 mm
