Fotomaterjal/dolly/Solidworks/Battery/CONNECTOR, MULTIPLEX, PLUG.SLDPRT

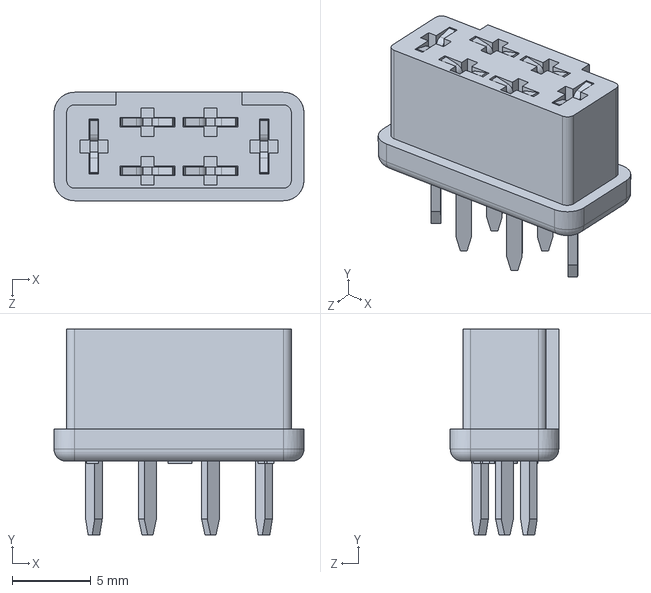
[picture p40: CAD file, 2015-04-08]
Solidworks/Battery/CONNECTOR, MULTIPLEX, PLUG.SLDPRT
15.9 x 13.1 x 6.89 mm
