Fotomaterjal/dolly/Solidworks/PCB/pcbBox_top.SLDPRT

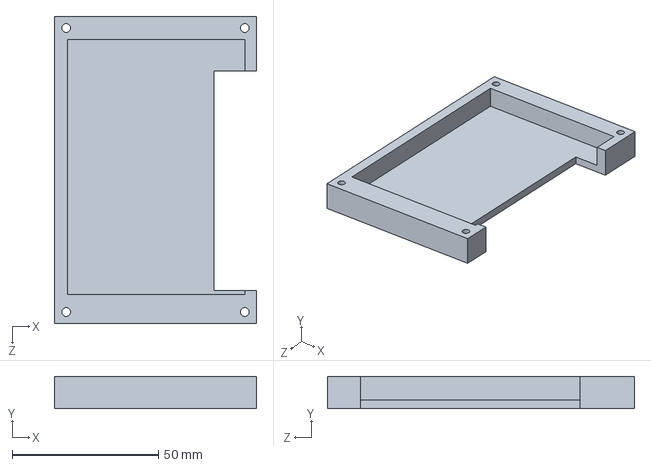
[picture p41: CAD file, 2015-04-08]
Solidworks/PCB/pcbBox_top.SLDPRT
69.0 x 11.0 x 105.0 mm
