Fotomaterjal/dolly/Solidworks/Sleigh/Roller Module/WheelHandler_bearing.SLDPRT

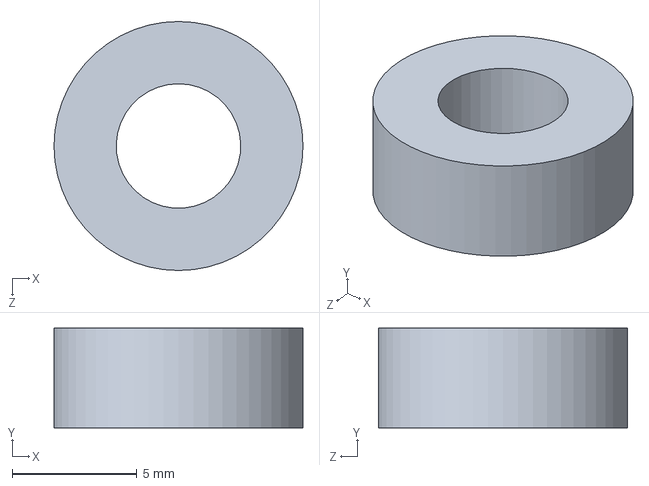
[picture p42: CAD file, 2015-04-08]
Solidworks/Sleigh/Roller Module/WheelHandler_bearing.SLDPRT
10.0 x 4.00 x 10.0 mm
