Fotomaterjal/dolly/Solidworks/Sleigh/Vertical Rotation/verRotate_adapter_cover.SLDPRT

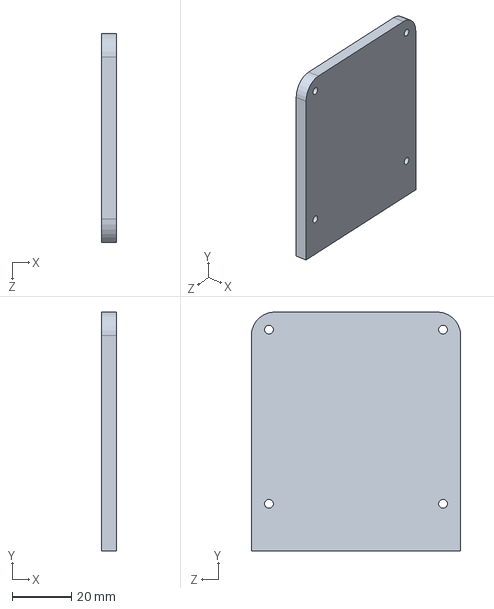
[picture p43: CAD file, 2015-04-08]
Solidworks/Sleigh/Vertical Rotation/verRotate_adapter_cover.SLDPRT
5.00 x 81.0 x 71.0 mm
