Fotomaterjal/dolly/Solidworks/Stepper/Pulley_HTD3M 20T.SLDPRT

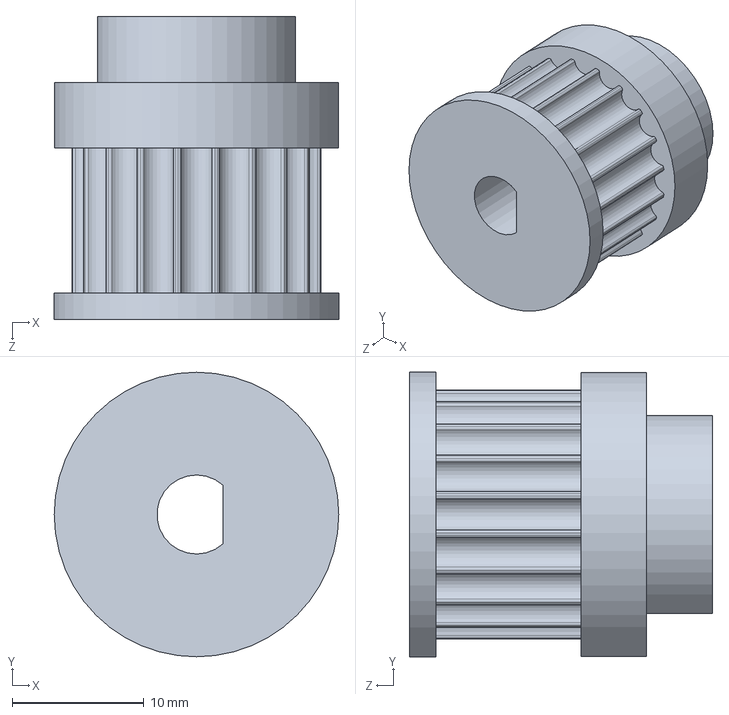
[picture p44: CAD file, 2015-04-08]
Solidworks/Stepper/Pulley_HTD3M 20T.SLDPRT
21.6 x 21.6 x 23.0 mm
