Fotomaterjal/dolly/Solidworks/PCB/pcbBox_bottom.SLDPRT

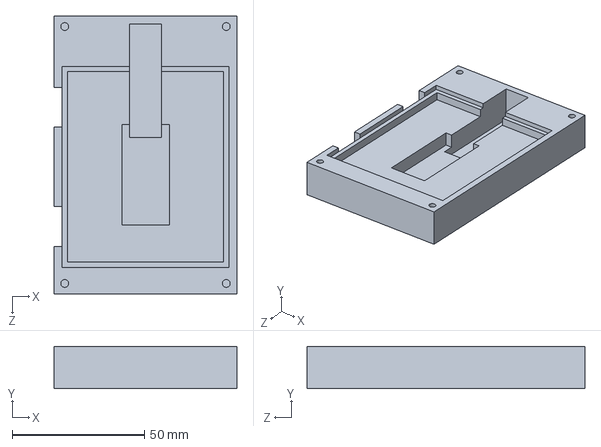
[picture p45: CAD file, 2015-04-08]
Solidworks/PCB/pcbBox_bottom.SLDPRT
69.0 x 16.0 x 105.0 mm
