Fotomaterjal/dolly/Solidworks/Sleigh/Horizontal Rotation/LazySusan_part.SLDPRT

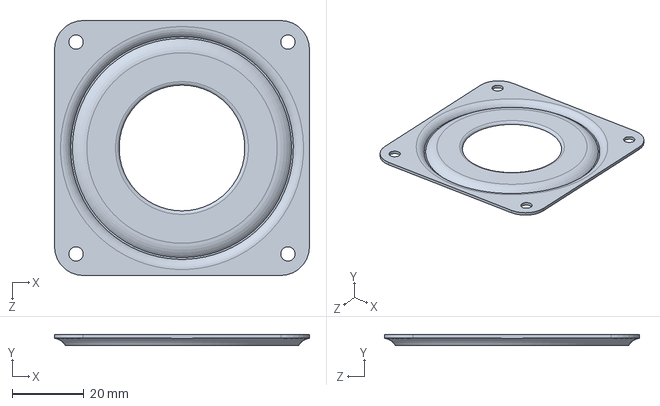
[picture p46: CAD file, 2015-04-08]
Solidworks/Sleigh/Horizontal Rotation/LazySusan_part.SLDPRT
71.0 x 3.00 x 71.0 mm
