Fotomaterjal/dolly/Solidworks/Sleigh/Roller Module/WheelHandler_mock_tube.SLDPRT

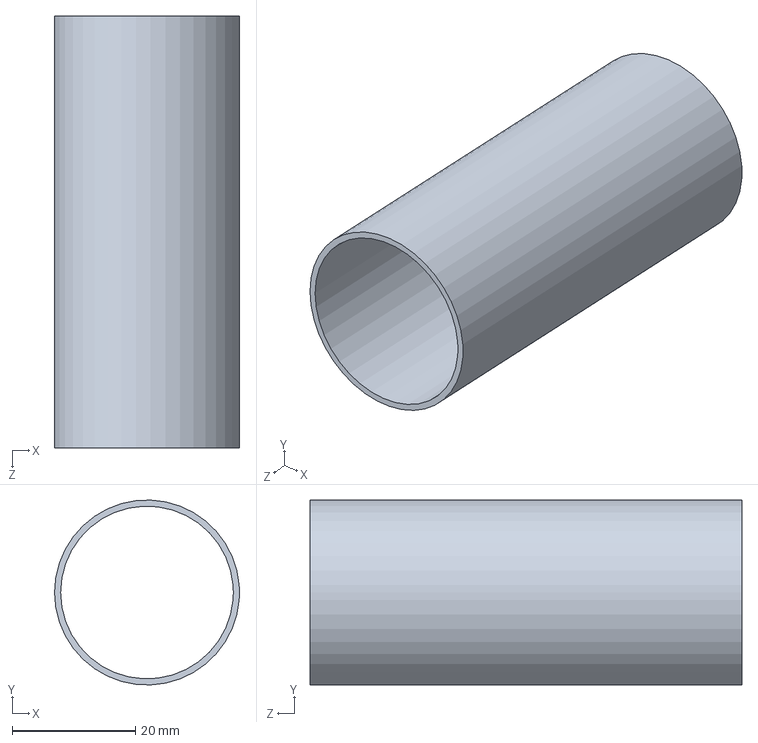
[picture p47: CAD file, 2015-04-08]
Solidworks/Sleigh/Roller Module/WheelHandler_mock_tube.SLDPRT
30.0 x 30.0 x 70.0 mm
