Fotomaterjal/dolly/Solidworks/Sleigh/Vertical Rotation/verRotate_90degree_camera_bracket.SLDPRT

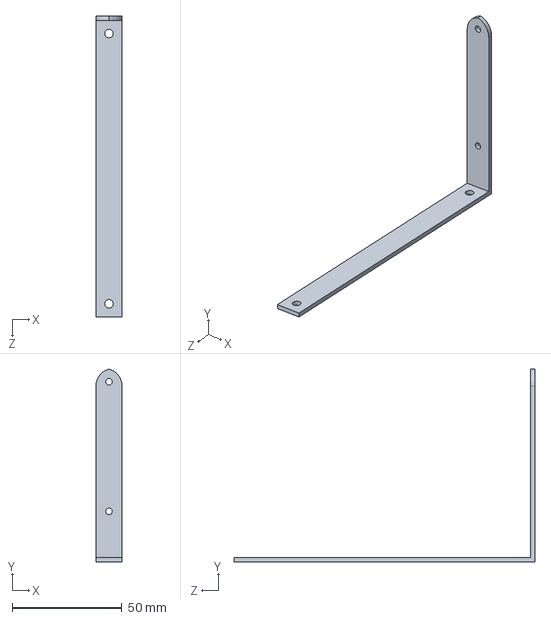
[picture p48: CAD file, 2015-04-08]
Solidworks/Sleigh/Vertical Rotation/verRotate_90degree_camera_bracket.SLDPRT
12.0 x 87.7 x 137.0 mm
