Fotomaterjal/dolly/Solidworks/Bottom/Sideblock_sideplate_wo_beltfastener.SLDPRT

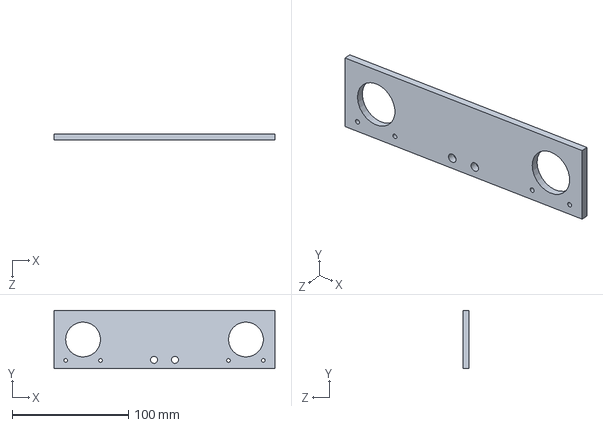
[picture p49: CAD file, 2015-06-13]
Solidworks/Bottom/Sideblock_sideplate_wo_beltfastener.SLDPRT
190.0 x 50.0 x 5.00 mm
