Fotomaterjal/dolly/Solidworks/Sleigh/Roller Module/WheelHandler_wheel_flat.SLDPRT

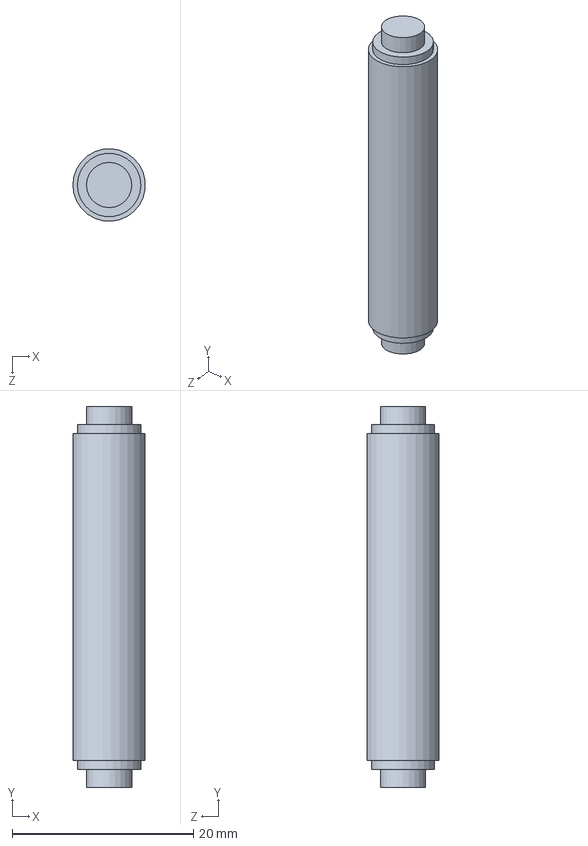
[picture p50: CAD file, 2015-04-08]
Solidworks/Sleigh/Roller Module/WheelHandler_wheel_flat.SLDPRT
7.97 x 42.0 x 7.99 mm
