Fotomaterjal/dolly/Solidworks/Stepper/Hex_M3x15.SLDPRT

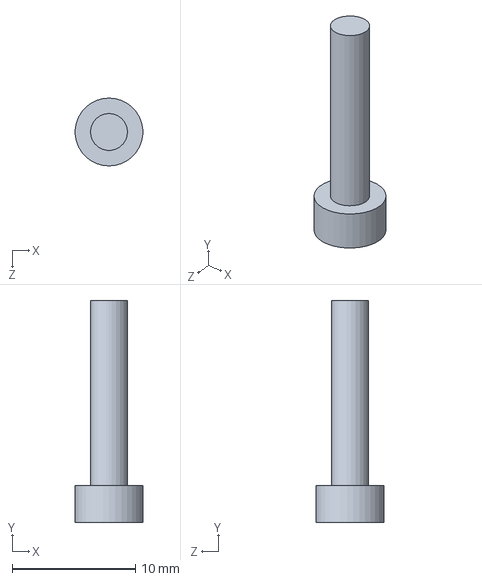
[picture p51: CAD file, 2015-04-08]
Solidworks/Stepper/Hex_M3x15.SLDPRT
5.48 x 18.0 x 5.50 mm
