Fotomaterjal/dolly/Solidworks/Sleigh/Vertical Rotation/verRotate_90degree_bracket.SLDPRT

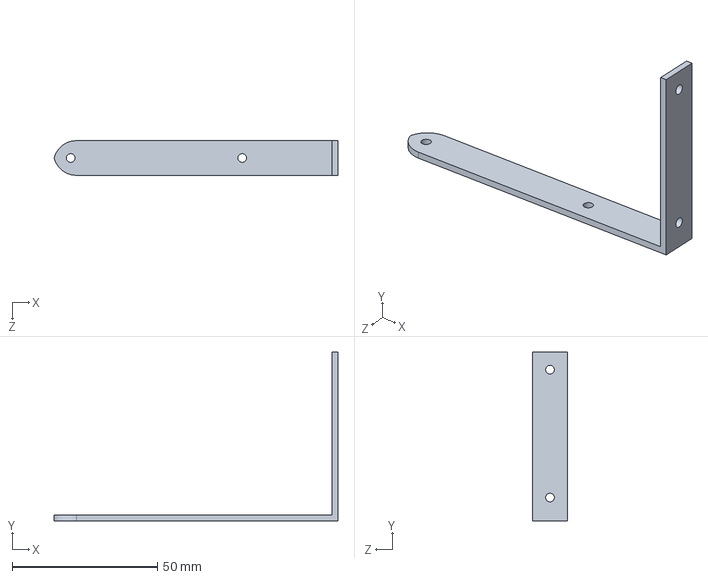
[picture p52: CAD file, 2015-04-08]
Solidworks/Sleigh/Vertical Rotation/verRotate_90degree_bracket.SLDPRT
97.7 x 58.0 x 12.0 mm
