Fotomaterjal/dolly/Solidworks/Stepper/Hex_M3x10.SLDPRT

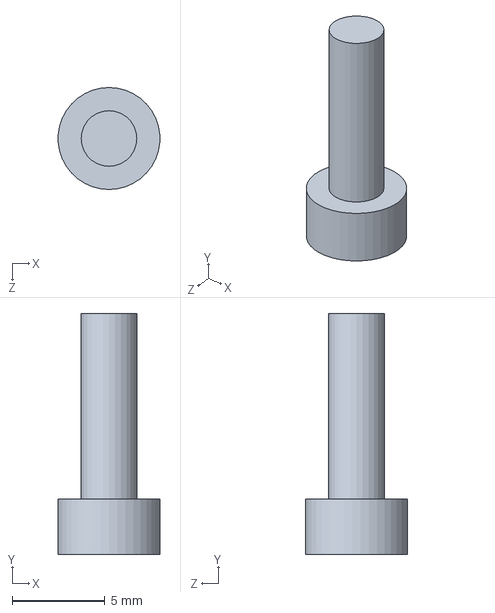
[picture p53: CAD file, 2015-04-08]
Solidworks/Stepper/Hex_M3x10.SLDPRT
5.48 x 13.0 x 5.50 mm
