Fotomaterjal/dolly/Solidworks/Bottom/1200mm carbon tube.SLDPRT

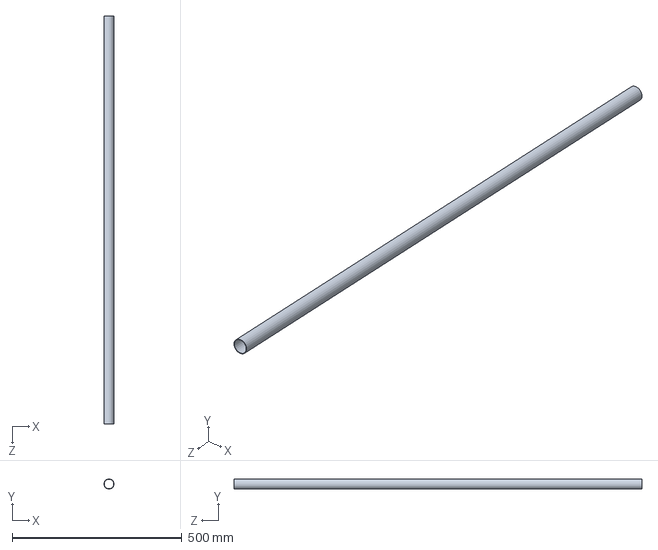
[picture p54: CAD file, 2015-03-20]
Solidworks/Bottom/1200mm carbon tube.SLDPRT
30.0 x 30.0 x 1200.0 mm
