Fotomaterjal/dolly/Solidworks/Stepper/Gearbox.SLDPRT

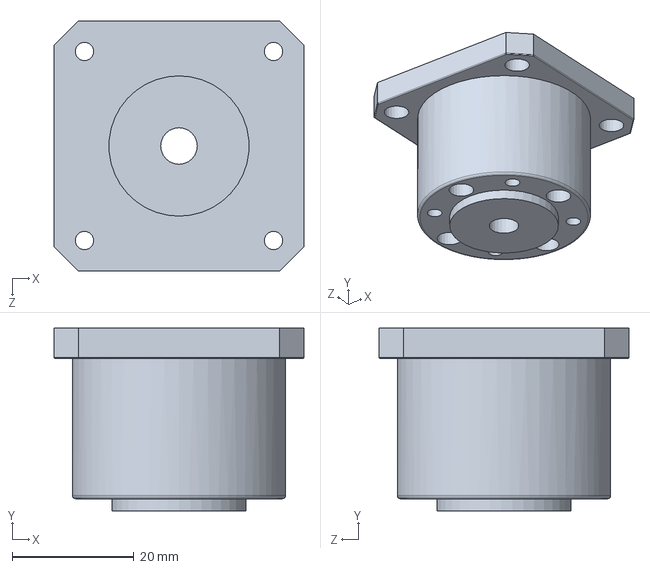
[picture p55: CAD file, 2015-04-08]
Solidworks/Stepper/Gearbox.SLDPRT
41.0 x 30.0 x 41.0 mm
