Fotomaterjal/dolly/Solidworks/Stepper/Cuerpo.SLDPRT

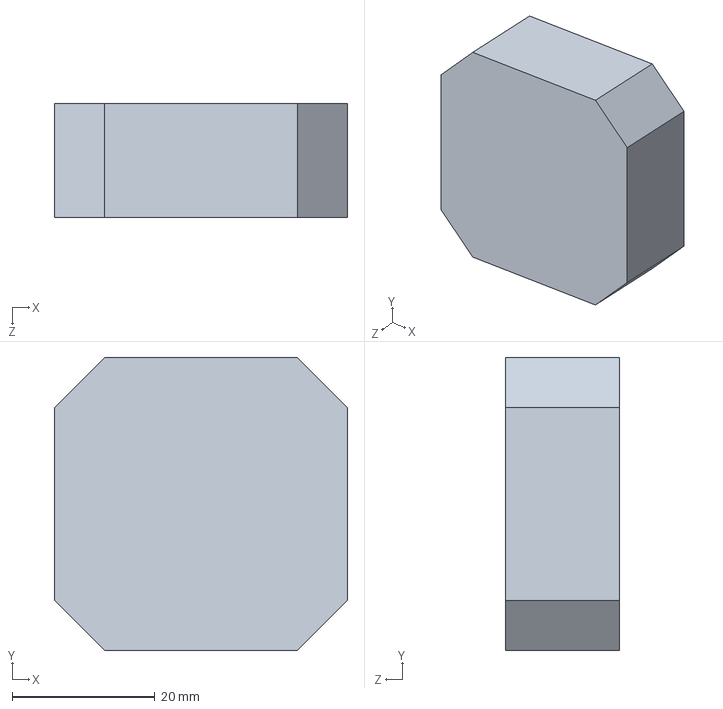
[picture p56: CAD file, 2015-03-20]
Solidworks/Stepper/Cuerpo.SLDPRT
41.0 x 41.0 x 16.0 mm
