Fotomaterjal/dolly/Solidworks/Stepper/GT2_20tooth.SLDPRT

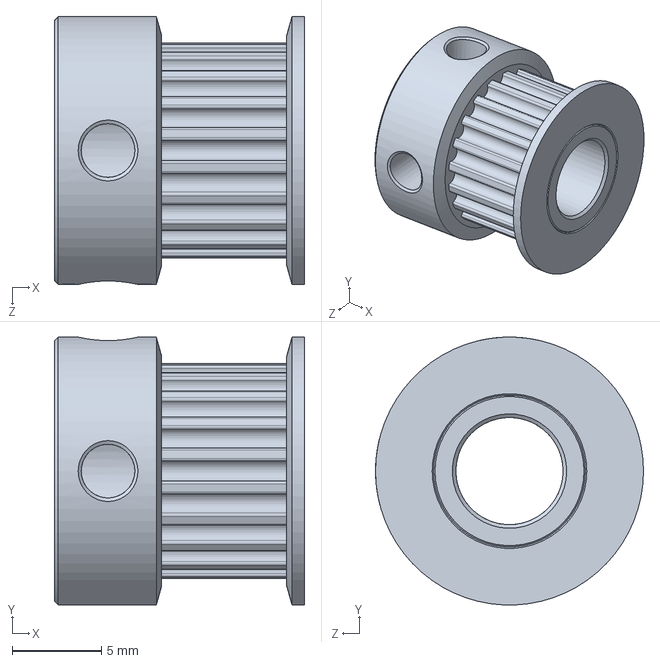
[picture p57: CAD file, 2015-03-20]
Solidworks/Stepper/GT2_20tooth.SLDPRT
14.0 x 15.0 x 15.0 mm
