Fotomaterjal/dolly/Solidworks/Stepper/Eje.SLDPRT

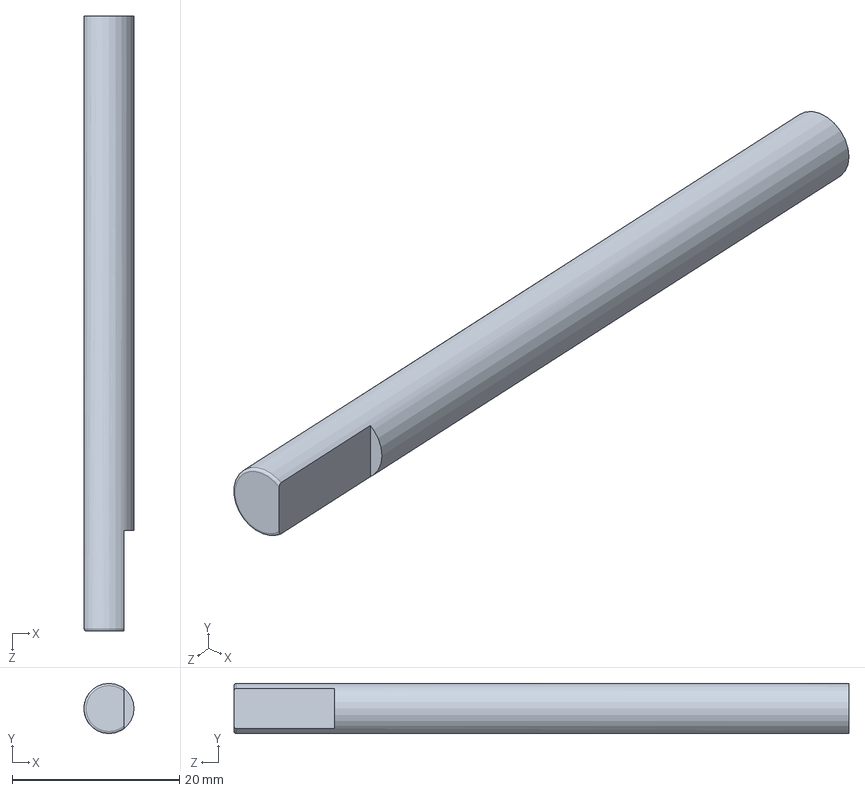
[picture p58: CAD file, 2015-03-20]
Solidworks/Stepper/Eje.SLDPRT
6.00 x 6.00 x 73.5 mm
