Fotomaterjal/dolly/Solidworks/Stepper/nema17_flange_mount.STEP

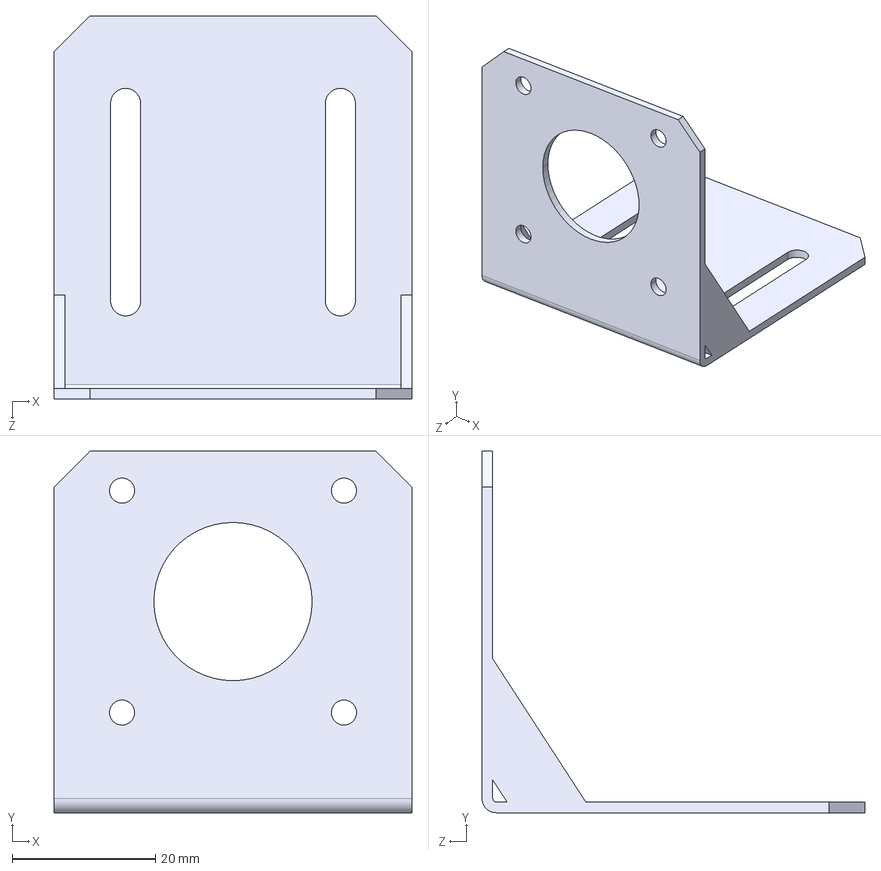
[picture p59: CAD file, 2015-01-19]
Solidworks/Stepper/nema17_flange_mount.STEP
50.0 x 50.5 x 53.5 mm
