Fotomaterjal/dolly/Solidworks/Stepper/GT2_cut.SLDPRT

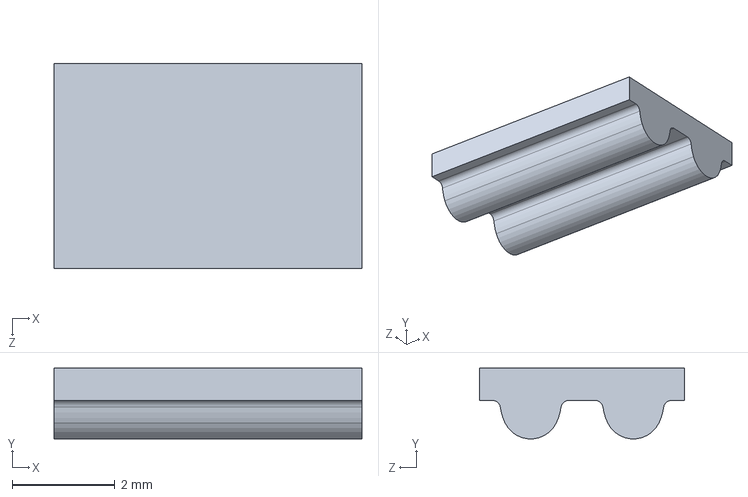
[picture p60: CAD file, 2015-01-19]
Solidworks/Stepper/GT2_cut.SLDPRT
6.00 x 1.38 x 4.00 mm
