Fotomaterjal/dolly/(list of files, cad)

Other CAD files:
Solidworks/Bottom/Sideblock_module_other_side.SLDASM
Solidworks/Stepper/NEMA 17.SLDASM
Solidworks/Sleigh/Horizontal Rotation/HorRotateAdapter2DimTop.SLDPRT
Solidworks/Sleigh/Vertical Rotation/Aluminum_krauta/verRotate_90degree_bracket.SLDPRT
Solidworks/Sleigh/Vertical Rotation/Aluminum_krauta/verRotate_90degree_camera_bracket_al_other side.SLDPRT
Solidworks/Bottom/Sideblock_sideplate_w_beltfastener_other_side.SLDPRT
Solidworks/Bottom/Sideblock_sideplate_w_beltfastener.SLDPRT
Solidworks/Backup/Wheel handler 2.3/BlockPart_1_2.3.SLDPRT
Solidworks/Backup/Wheel handler 2.3/BlockPart_2_2.3.SLDPRT
Solidworks/Backup/Wheel handler 2.3/Block_2.3.SLDPRT
Solidworks/Backup/Wheel handler 2.3/Roller module_2.3.SLDASM
Solidworks/Backup/wheel_2.2.SLDPRT
Solidworks/Bottom/Bolts 'n' nuts/Philips_screw_M3x10.SLDPRT
Solidworks/Bottom/Bolts 'n' nuts/Philips_screw_M3x15.SLDPRT
Solidworks/Bottom/Bolts 'n' nuts/Philips_screw_M3x25.SLDPRT
Solidworks/Bottom/Bolts 'n' nuts/Philips_screw_M3x30.SLDPRT
Solidworks/Bottom/Bolts 'n' nuts/Tripod_plate_bolt.SLDPRT
Solidworks/Bottom/Bolts 'n' nuts/Tripod_plate_nut.SLDPRT
Solidworks/Sleigh/Belt handling/Belt_bolt.SLDPRT
Solidworks/Sleigh/Belt handling/Belt_bolt_bearing.SLDPRT
Solidworks/Sleigh/Horizontal Rotation/Tripod_head bolt.SLDPRT
Solidworks/Sleigh/Linear movement/Screw_bearing adapter.SLDPRT
Solidworks/Stepper/Hex_M3 nut.SLDPRT
Solidworks/Stepper/nema17_flange_mount.SLDPRT
Solidworks/To cut/Smaller parts/Sideplates.SLDDRW
Solidworks/To cut/Smaller parts/Sleigh_top_plate.SLDDRW
Solidworks/To cut/Smaller parts/VerRotate_assembly base_long & sideplates wo beltfastener.SLDDRW
Solidworks/To cut/Smaller parts/verRotate_camera_baseplate.SLDDRW
Solidworks/To cut/all1.SLDDRW
