Fotomaterjal/dolly/Progemine/Abiks ikka/Mikroprosede projekt/sten_prajekt_testing_pwm_4bit/TcfTransactionLog.csv

Service | Message | Max | Min | Average | Count | frequency | TimedOut
Stream | setLogBits | 13.0007 | 13.0007 | 13.0007 | 1 | 0
