Fotomaterjal/dolly/Progemine/Abiks ikka/Mikroprosede projekt/sten_testing_new_transmitter_with_accelerometer/TcfTransactionLog.csv

Service | Message | Max | Min | Average | Count | frequency | TimedOut
Stream | setLogBits | 13.0008 | 13.0008 | 13.0008 | 1 | 0
