Fotomaterjal/dolly/Eagle/Bachelor/main_schematic.pdf

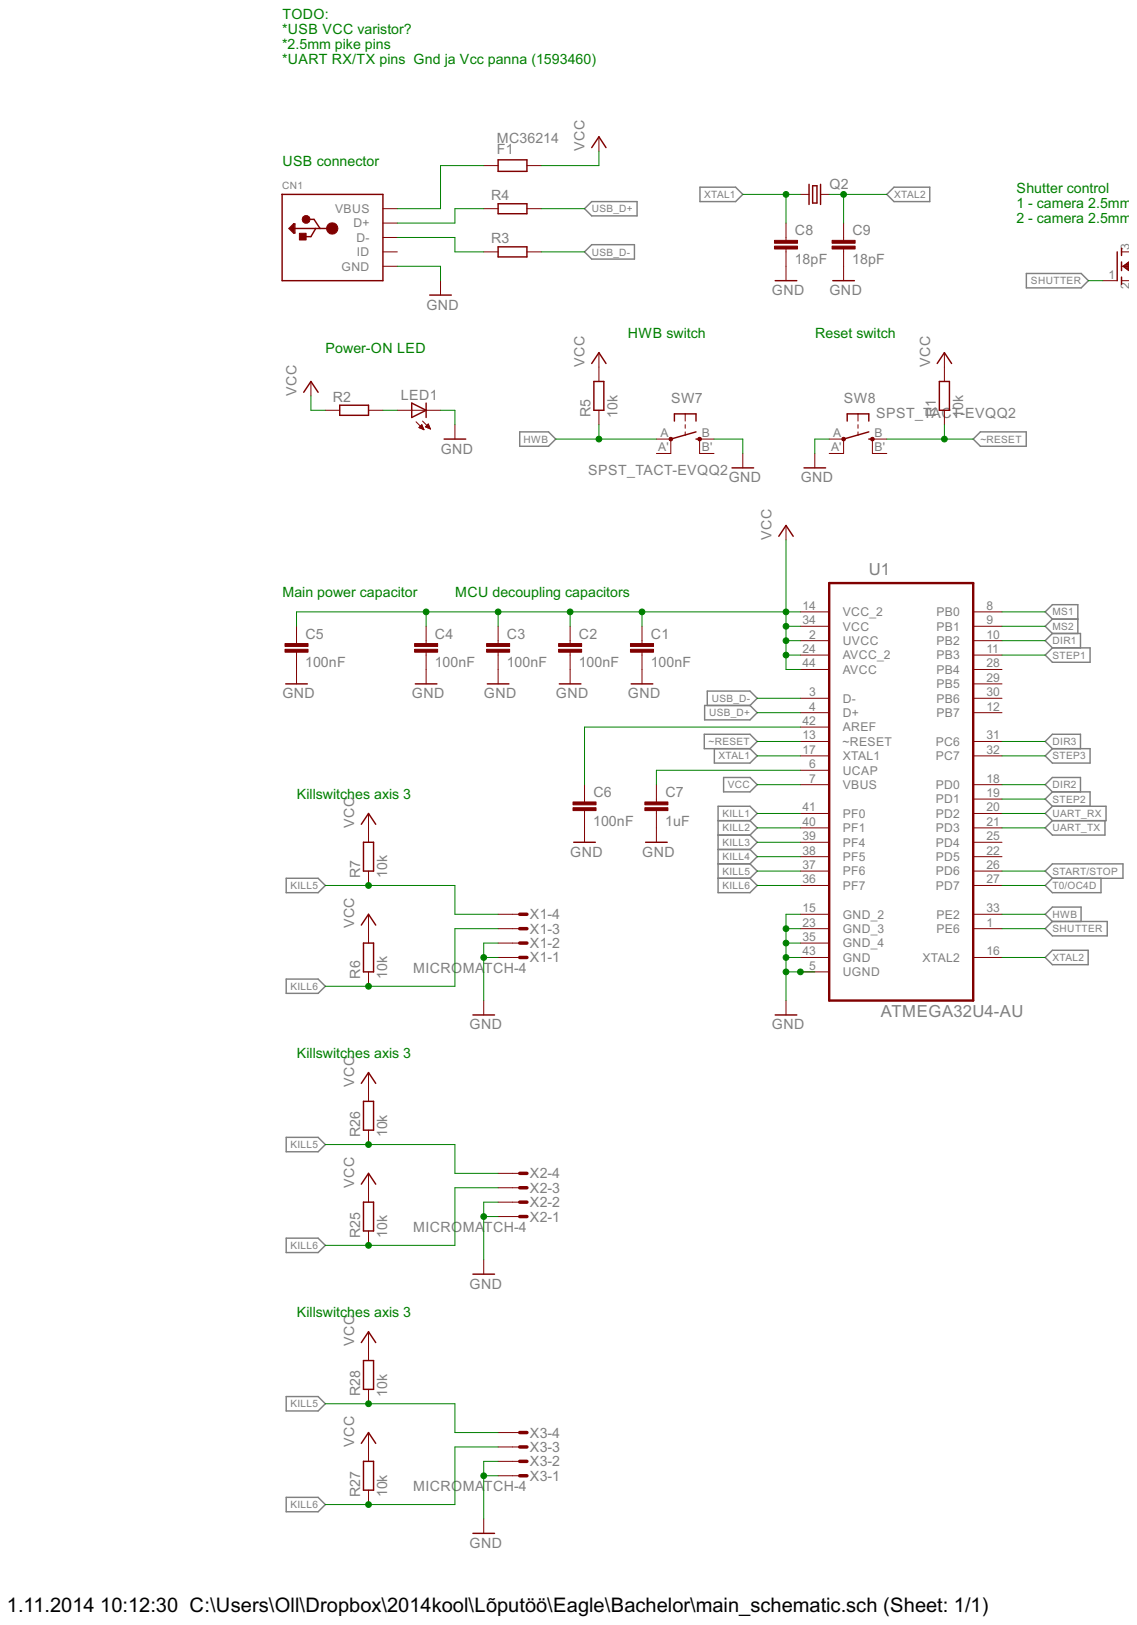
[picture p61: page 1]

TODO: *USB VCC varistor?

*2.5mm pike pins
*UART RX/TX pins Gnd ja Vcc panna (1593460)

1.11.2014 10:12:30 C:\Users\Oll\Dropbox\2014kool\Lõputöö\Eagle\Bachelor\main_schematic.sch (Sheet: 1/1)

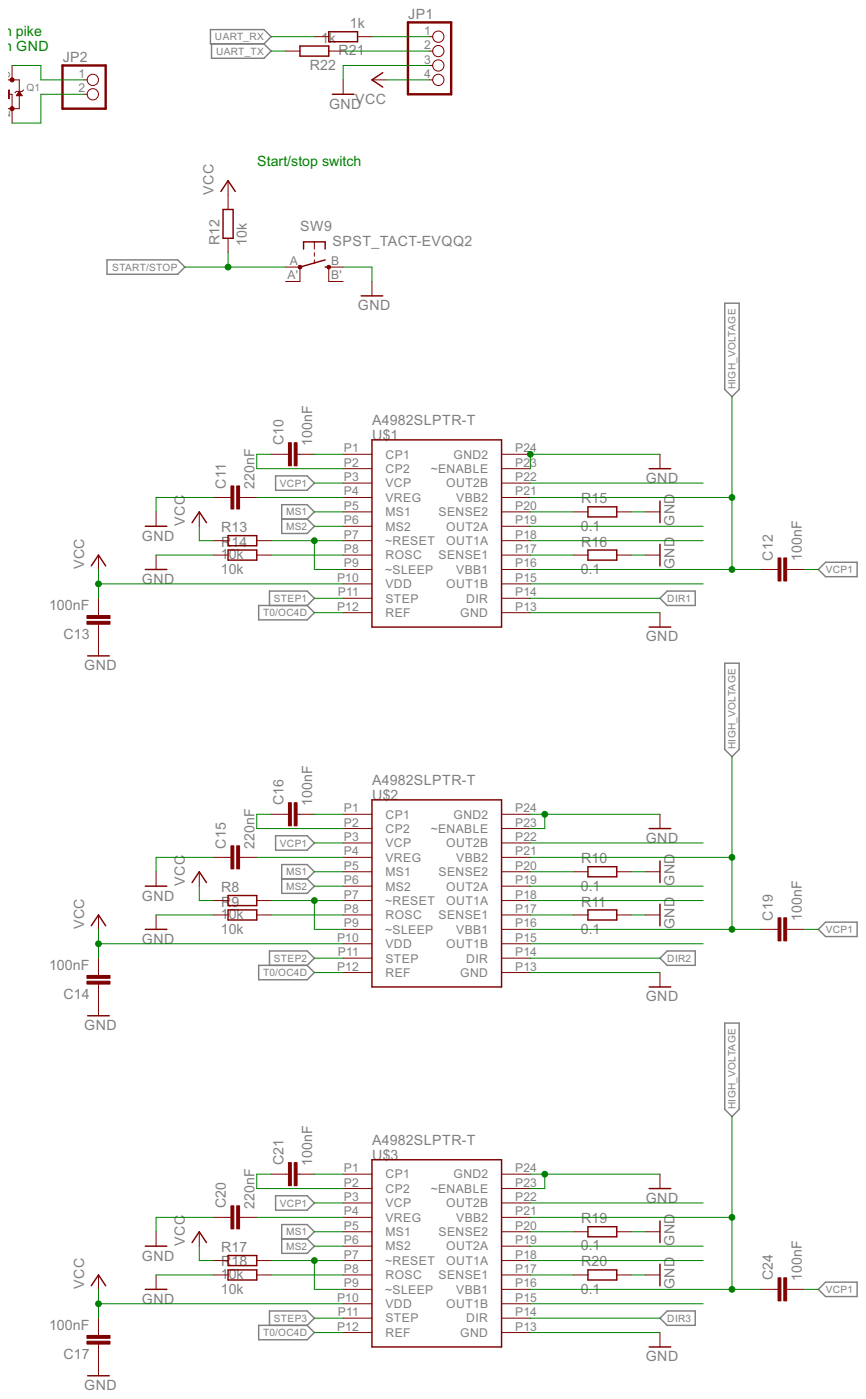
[picture p62: page 2]
