Fotomaterjal/dolly/Eagle/Bachelor/main_schematic.brd

## EAGLE design Eagle/Bachelor/main_schematic.brd (2015-06-13)

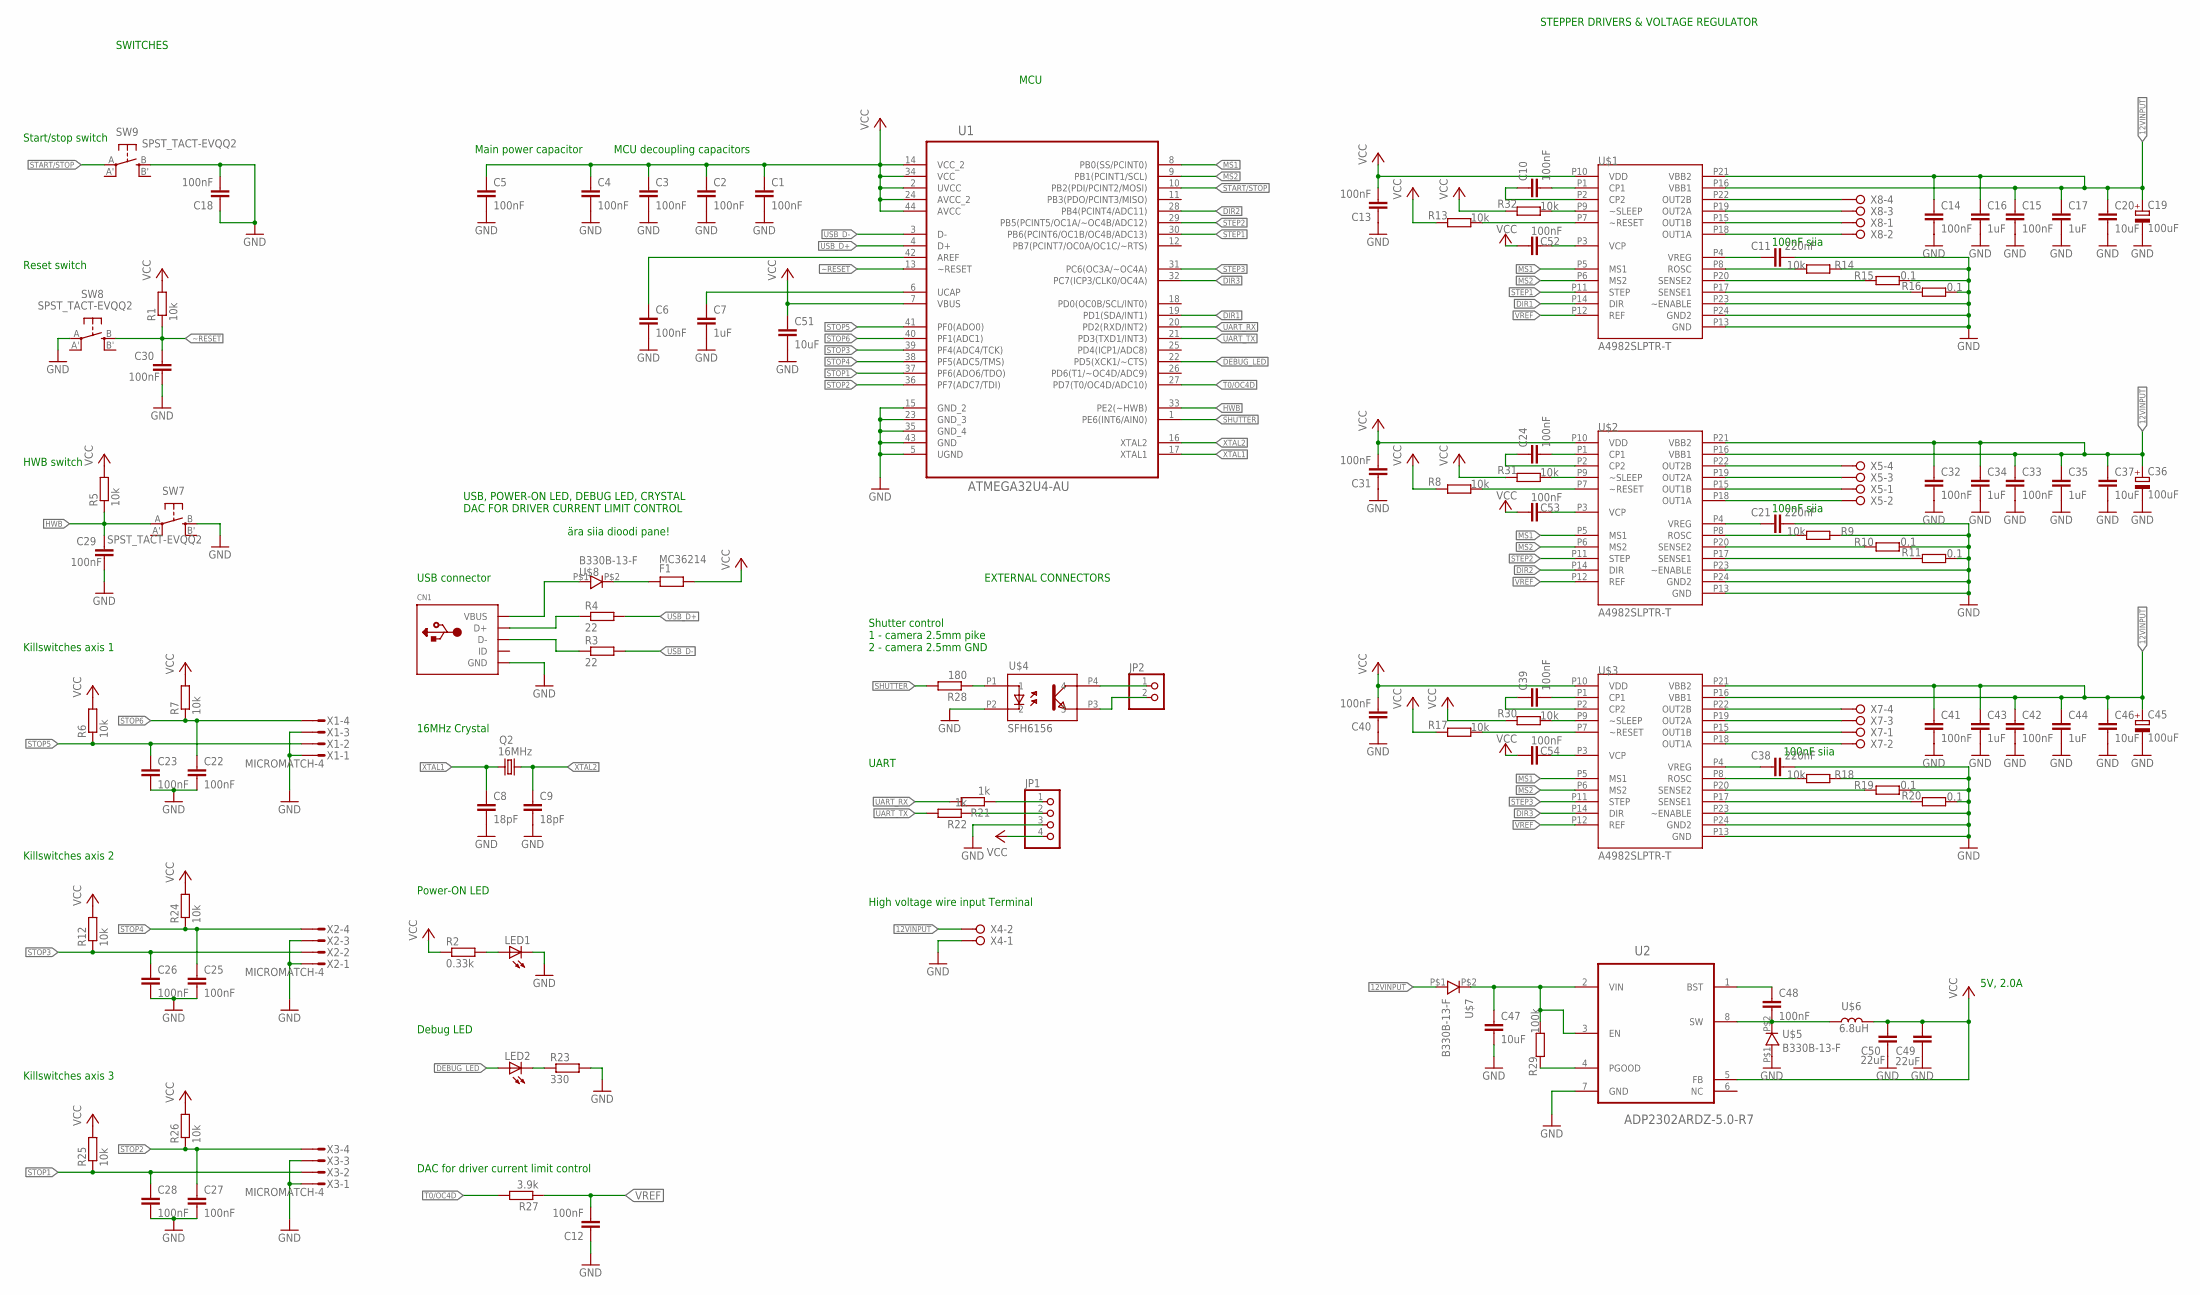
[picture p63: schematic main_schematic.sch]

Parts:
C1, C2, C3, C4, C5, C6, C10, C12, C13, C14, C15, C18, C22, C23, C24, C25, C26, C27, C28, C29, C30, C31, C32, C33, C39, C40, C41, C42, C52, C53, C54: 100nF; C0603K
C7, C16, C17, C34, C35, C43, C44: 1uF; C0603K
C8, C9: 18pF; C0603K
C11, C21, C38: 220nF; C0603K
C19, C36, C45: 100uF; E/7260-38R
C20, C37, C46, C47: 10uF; C1206K
C48: 100nF; C1206K
C49, C50: 22uF; C1206K
C51: 10uF; C0805
CN1: USBMINIB; USB-MINIB
F1: MC36214
JP1: PINHD-1X4; 1X04
JP2: PINHD-1X2; 1X02
LED1, LED2: LEDCHIP-LED0603; CHIP-LED0603
Q2: 16MHz; SM49
R1, R5, R6, R7, R8, R9, R12, R13, R14, R17, R18, R24, R25, R26, R30, R31, R32: 10k; R0603
R2: 0.33k; R0603
R3, R4: 22; R0603
R10, R11, R15, R16, R19, R20: 0.1; R0805
R21, R22: 1k; R0603
R23: 330; R0603
R27: 3.9k; R0603
R28: 180; R0603
R29: 100k; R0603
SW7, SW8, SW9: SPST_TACT-EVQQ2; EVQ-Q2
U1: ATMEGA32U4-AU; QFP80P1200X1200X120-44N
U2: ADP2302ARDZ-5.0-R7; SOIC127P600X175-9N
U$1, U$2, U$3: A4982SLPTR-T; TSSOP_24
U$4: SFH6156; SFH6165
U$5, U$7, U$8: B330B-13-F
U$6: 6.8uH; VLF10040
X1, X2, X3: MICROMATCH-4
X4: W237-02P; W237-132
X5, X7, X8: W237-04P; W237-4P

Connections:
12VINPUT: C14.1, C15.1, C16.1, C17.1, C19.+, C20.1, C32.1, C33.1, C34.1, C35.1, C36.+, C37.1, C41.1, C42.1, C43.1, C44.1, C45.+, C46.1, U$1.P16 (VBB1), U$1.P21 (VBB2), U$2.P16 (VBB1), U$2.P21 (VBB2), U$3.P16 (VBB1), U$3.P21 (VBB2), U$7.P$1, X4.2
DEBUG_LED: LED2.A, U1.22 (PD5(XCK1/~CTS))
DIR1: U1.19 (PD1(SDA/INT1)), U$1.P14 (DIR)
DIR2: U1.28 (PB4(PCINT4/ADC11)), U$2.P14 (DIR)
DIR3: U1.32 (PC7(ICP3/CLK0/OC4A)), U$3.P14 (DIR)
GND: C1.2, C2.2, C3.2, C4.2, C5.2, C6.2, C7.2, C8.2, C9.2, C11.1, C12.1, C13.1, C14.2, C15.2, C16.2, C17.2, C18.1, C18.2, C19.-, C20.2, C21.1, C22.2, C23.2, C25.2, C26.2, C27.2, C28.2, C29.2, C30.2, C31.1, C32.2, C33.2, C34.2, C35.2, C36.-, C37.2, C38.1, C40.1, C41.2, C42.2, C43.2, C44.2, C45.-, C46.2, C47.2, C49.1, C50.1, C51.2, CN1.GND, JP1.3, LED1.C, R9.1, R10.2, R11.2, R14.1, R15.2, R16.2, R18.1, R19.2, R20.2, R23.2, SW7.B (S), SW8.A, SW9.B (S), U1.5 (UGND), U1.15 (GND_2), U1.23 (GND_3), U1.35 (GND_4), U1.43 (GND), U2.7 (GND), U$1.P13 (GND), U$1.P23 (~ENABLE), U$1.P24 (GND2), U$2.P13 (GND), U$2.P23 (~ENABLE), U$2.P24 (GND2), U$3.P13 (GND), U$3.P23 (~ENABLE), U$3.P24 (GND2), U$4.P2 (2), U$5.P$1, X1.1, X1.3, X2.1, X2.3, X3.1, X3.3, X4.1
HIGH_VOLTAEG: C47.1, R29.2, U2.2 (VIN), U2.3 (EN), U$7.P$2
HWB: C29.1, R5.1, SW7.A, U1.33 (PE2(~HWB))
MS1: U1.8 (PB0(SS/PCINT0)), U$1.P5 (MS1), U$2.P5 (MS1), U$3.P5 (MS1)
MS2: U1.9 (PB1(PCINT1/SCL)), U$1.P6 (MS2), U$2.P6 (MS2), U$3.P6 (MS2)
unnamed: JP2.1, U$4.P4 (4)
unnamed: C6.1, U1.42 (AREF)
unnamed: LED1.A, R2.2
unnamed: CN1.D-, R3.1
unnamed: CN1.D+, R4.1
unnamed: C10.2, U$1.P1 (CP1)
unnamed: C10.1, U$1.P2 (CP2)
unnamed: U$1.P15 (OUT1B), X8.1
unnamed: U$1.P22 (OUT2B), X8.4
unnamed: C11.2, U$1.P4 (VREG)
unnamed: C7.1, U1.6 (UCAP)
unnamed: R13.2, U$1.P7 (~RESET)
unnamed: C24.2, U$2.P1 (CP1)
unnamed: R14.2, U$1.P8 (ROSC)
unnamed: R15.1, U$1.P20 (SENSE2)
unnamed: R16.1, U$1.P17 (SENSE1)
unnamed: C24.1, U$2.P2 (CP2)
unnamed: U$1.P19 (OUT2A), X8.3
unnamed: R10.1, U$2.P20 (SENSE2)
unnamed: U$1.P18 (OUT1A), X8.2
unnamed: R11.1, U$2.P17 (SENSE1)
unnamed: U$2.P22 (OUT2B), X5.4
unnamed: U$2.P15 (OUT1B), X5.1
unnamed: U$2.P19 (OUT2A), X5.3
unnamed: U$2.P18 (OUT1A), X5.2
unnamed: C21.2, U$2.P4 (VREG)
unnamed: R8.2, U$2.P7 (~RESET)
unnamed: R9.2, U$2.P8 (ROSC)
unnamed: C39.2, U$3.P1 (CP1)
unnamed: C39.1, U$3.P2 (CP2)
unnamed: R19.1, U$3.P20 (SENSE2)
unnamed: R20.1, U$3.P17 (SENSE1)
unnamed: U$3.P22 (OUT2B), X7.4
unnamed: U$3.P15 (OUT1B), X7.1
unnamed: U$3.P19 (OUT2A), X7.3
unnamed: U$3.P18 (OUT1A), X7.2
unnamed: C38.2, U$3.P4 (VREG)
unnamed: R17.2, U$3.P7 (~RESET)
unnamed: CN1.VBUS, U$8.P$1
unnamed: JP1.1, R21.1
unnamed: JP1.2, R22.1
unnamed: JP2.2, U$4.P3 (3)
unnamed: R18.2, U$3.P8 (ROSC)
unnamed: LED2.C, R23.1
unnamed: R29.1, U2.4 (PGOOD)
unnamed: C48.1, U2.1 (BST)
unnamed: R28.1, U$4.P1 (1)
unnamed: F1.P$1, U$8.P$2
unnamed: C52.1, U$1.P3 (VCP)
unnamed: C48.2, U2.8 (SW), U$5.P$2, U$6.P$2
unnamed: C53.1, U$2.P3 (VCP)
unnamed: C54.1, U$3.P3 (VCP)
unnamed: R30.2, U$3.P9 (~SLEEP)
unnamed: R31.2, U$2.P9 (~SLEEP)
unnamed: R32.2, U$1.P9 (~SLEEP)
SHUTTER: R28.2, U1.1 (PE6(INT6/AIN0))
START/STOP: SW9.A, U1.10 (PB2(PDI/PCINT2/MOSI))
STEP1: U1.30 (PB6(PCINT6/OC1B/OC4B/ADC13)), U$1.P11 (STEP)
STEP2: U1.29 (PB5(PCINT5/OC1A/~OC4B/ADC12)), U$2.P11 (STEP)
STEP3: U1.31 (PC6(OC3A/~OC4A)), U$3.P11 (STEP)
STOP1: C28.1, R25.1, U1.37 (PF6(ADO6/TDO)), X3.2
STOP2: C27.1, R26.1, U1.36 (PF7(ADC7/TDI)), X3.4
STOP3: C26.1, R12.1, U1.39 (PF4(ADC4/TCK)), X2.2
STOP4: C25.1, R24.1, U1.38 (PF5(ADC5/TMS)), X2.4
STOP5: C23.1, R6.1, U1.41 (PF0(ADO0)), X1.2
STOP6: C22.1, R7.1, U1.40 (PF1(ADC1)), X1.4
T0/OC4D: R27.2, U1.27 (PD7(T0/OC4D/ADC10))
UART_RX: R21.2, U1.20 (PD2(RXD/INT2))
UART_TX: R22.2, U1.21 (PD3(TXD1/INT3))
USB_D+: R4.2, U1.4 (D+)
USB_D-: R3.2, U1.3 (D-)
VCC: C1.1, C2.1, C3.1, C4.1, C5.1, C13.2, C31.2, C40.2, C49.2, C50.2, C51.1, C52.2, C53.2, C54.2, F1.P$2, JP1.4, R1.2, R2.1, R5.2, R6.2, R7.2, R8.1, R12.2, R13.1, R17.1, R24.2, R25.2, R26.2, R30.1, R31.1, R32.1, U1.2 (UVCC), U1.7 (VBUS), U1.14 (VCC_2), U1.24 (AVCC_2), U1.34 (VCC), U1.44 (AVCC), U2.5 (FB), U$1.P10 (VDD), U$2.P10 (VDD), U$3.P10 (VDD), U$6.P$1
VREF: C12.2, R27.1, U$1.P12 (REF), U$2.P12 (REF), U$3.P12 (REF)
XTAL1: C8.1, Q2.1, U1.17 (XTAL1)
XTAL2: C9.1, Q2.2, U1.16 (XTAL2)
~RESET: C30.1, R1.1, SW8.B (S), U1.13 (~RESET)

Notes on the sheet:
MCU decoupling capacitors
Main power capacitor
Reset switch
Power-ON LED
USB connector
HWB switch
Start/stop switch
Killswitches axis 1
Killswitches axis 2
Killswitches axis 3
Debug LED
16MHz Crystal
Shutter control 1 - camera 2.5mm pike 2 - camera 2.5mm GND
DAC for driver current limit control
UART
High voltage wire input Terminal
5V, 2.0A
SWITCHES
MCU
USB, POWER-ON LED, DEBUG LED, CRYSTAL DAC FOR DRIVER CURRENT LIMIT CONTROL
STEPPER DRIVERS & VOLTAGE REGULATOR
EXTERNAL CONNECTORS
ära siia dioodi pane!
100nF siia

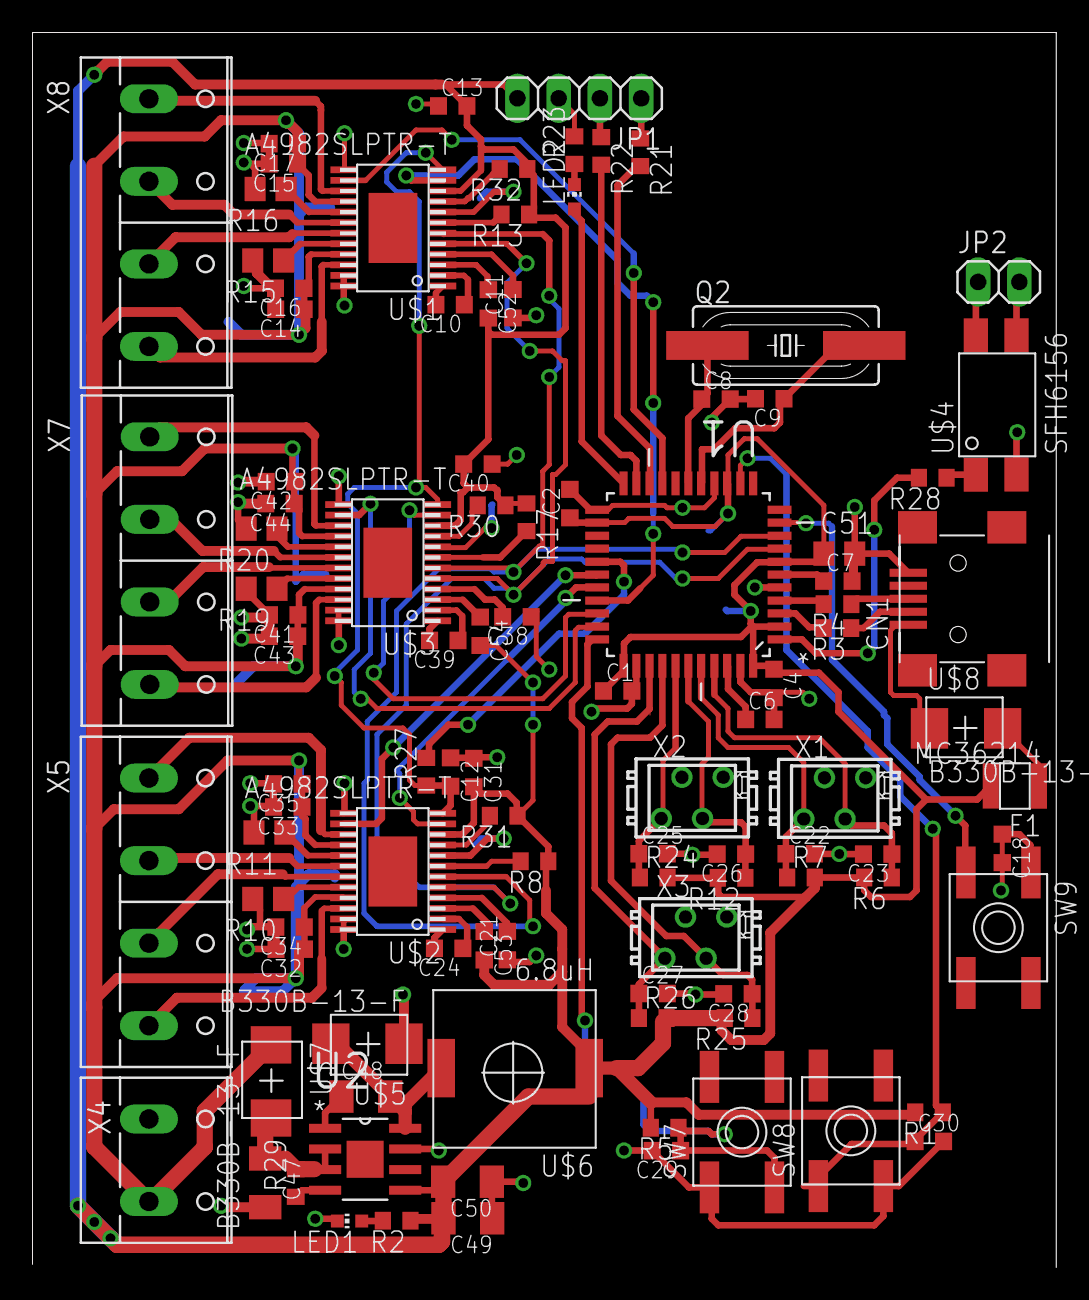
[picture p64: board main_schematic.brd from above]

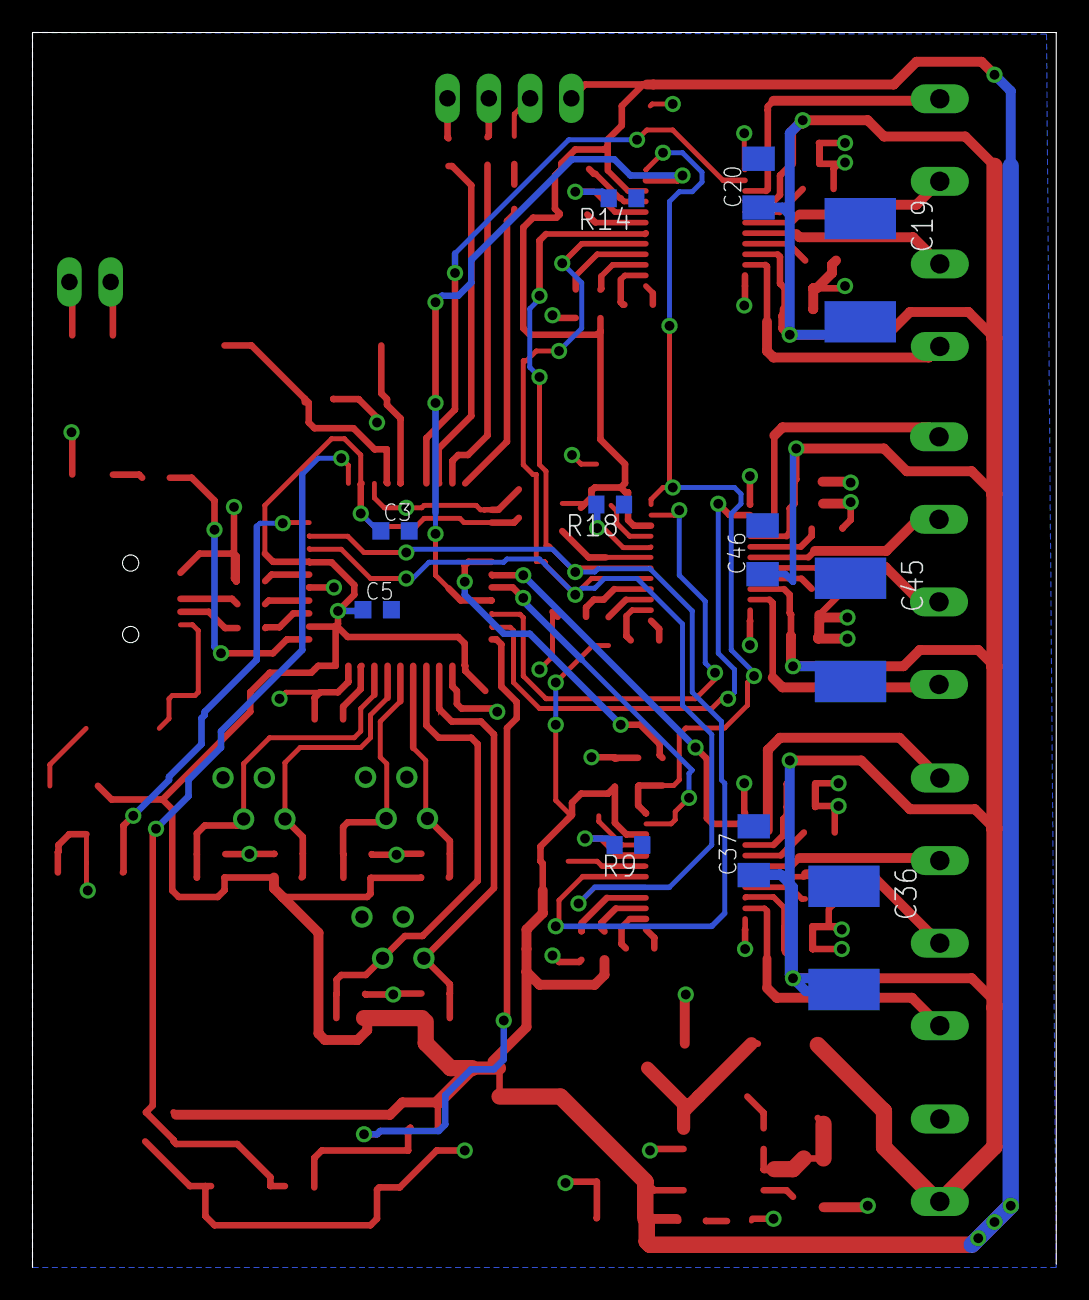
[picture p65: board main_schematic.brd from below]

Board: 2 copper layers, 63.0 x 76.0 mm, 113 parts (11 on the bottom side), 86 nets.
