Fotomaterjal/dolly/Eagle/Erilabor/erilabor.brd

## EAGLE design Eagle/Erilabor/erilabor.brd (2015-01-03)

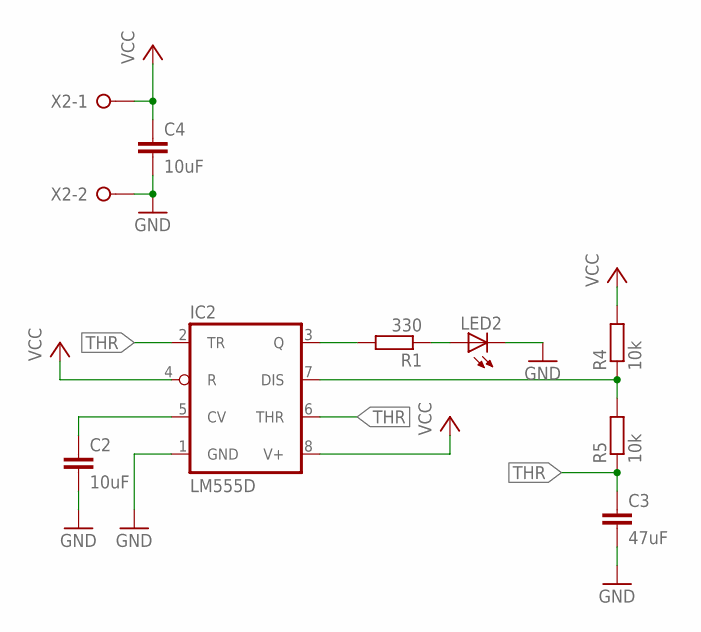
[picture p66: schematic erilabor.sch]

Parts:
C2, C4: 10uF; C0805K
C3: 47uF; C1210K
IC2: LM555D; SO08
LED2: LEDCHIP-LED0603; CHIP-LED0603
R1: 330; R0603
R4, R5: 10k; R0603
X2: W237-2N

Connections:
GND: C2.2, C3.2, C4.2, IC2.1 (GND), LED2.C, X2.2
unnamed: IC2.3 (Q), R1.2
unnamed: LED2.A, R1.1
unnamed: C2.1, IC2.5 (CV)
unnamed: IC2.7 (DIS), R4.1, R5.2
THR: C3.1, IC2.2 (TR), IC2.6 (THR), R5.1
VCC: C4.1, IC2.4 (R), IC2.8 (V+), R4.2, X2.1

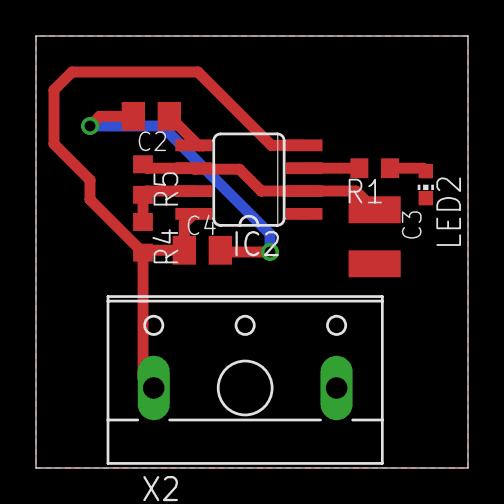
[picture p67: board erilabor.brd from above]

Board: 2 copper layers, 24.0 x 24.0 mm, 9 parts (0 on the bottom side), 7 nets.
