Fotomaterjal/dolly/(commit log)

2015-01-03 Esimene push kogu töökaustale
    [1200mm carbon tube.SLDPRT, Base.SLDPRT, Bolt.sldprt, Bottom.SLDASM, Cuerpo.SLDPRT, Eelarve_B26135_lõputöö.xlsx, Eje.SLDPRT, Electronics links.xlsx]
2015-01-19 Lisandus uus kaust "progemine" muutsin juurkausta nime flipile arusaadavamaks
    [Belt handler axle.SLDPRT, Belt handling module.SLDASM, Belt transmission.SLDPRT, GT2_20tooth.SLDPRT, GT2_cut.SLDPRT, NEMA 17.SLDASM, belt handler bearing.SLDPRT, belt handler bottom.SLDPRT]
2015-01-29 Tehtud solidworksi ja progemist
    [Bottom.SLDASM, NEMA 17.SLDASM, Side block3.SLDPRT, main.SLDASM]
2015-02-10 Igaks juhuks
    [NEMA 17.SLDASM]
2015-02-11 Kõik progemine seni
    [TcfTransactionLog.csv, ul1.sdf]
2015-02-12 Cleaned up the main code. I hope I didn't brake anything.
    [first.c]
2015-02-21 Fixed USART multiple byte receive corruption problem. Now can receive many keyframes at one time.
    [first.c]
2015-02-24 Code now changes Timer 1A compare match frequency depending on the USART receive vector. Aka code ready for receiving bluetooth signals for testing.
2015-03-06 conBT.write(asi); works and sending bytes to board!
2015-03-11 It is working but messing up the order of the received keyframes. Gonna try to fix this thing with sending extra order number from android app.
    [Main.c]
2015-03-20 Solidworks files before printing 20th march
    [1200mm carbon tube.SLDPRT, Base.SLDPRT, Belt handler axle.SLDPRT, Belt handling module.SLDASM, Belt transmission.SLDPRT, Bolt.sldprt, Bottom.SLDASM, Cuerpo.SLDPRT]
2015-03-24 Added all three stepper support and movement.
2015-04-08 A lot of stuff done Preparing to cut and print most of the stuff
    [2_NEMA 17.SLDASM, 8020-3048.SLDPRT, BTModule.SLDPRT, Battery.SLDASM, Belt tightener transmission.SLDASM, Belt_bolt.SLDPRT, Belt_bolt_bearing.SLDPRT, BlockPart_1_2.3.SLDPRT]
2015-04-08 Most of the stuff done, but have errors Error in android, nullpointerexception Verrotate and horrotate not working correctly
    [Main.c]
2015-04-21 Put onto microstepping mode. Everything working, steps working, keyframes working, backwards stepping working. Now Have to calibrate to work as slowly as needed and as fast as needed. Looking good (Y)
2015-04-26 All the timers seem to be working. A small problem with some numbers, for example travel 16 degrees in 3 seconds gives some problems on HorTimer somehow. Don't know the cause.
    [Main.c]
2015-04-29 Device moving working but ver thing still slower. Don't know the reason
2015-05-07 Changed uart not to use interrupts, seems to be working
2015-05-10 Everything in place but some screws missing
    [2_NEMA 17.SLDASM, Battery.SLDASM, Belt tightener transmission.SLDASM, HorRotateAdapter.SLDPRT, HorRotateAdapter2DimTop.SLDPRT, PCB assembly.SLDASM, Roller_module.SLDASM, Screw_bearing adapter.SLDPRT]
